markniu/PandaPi/doc/README.md

[Schematic_PandaPiV2.8.pdf](https://gitee.com/markyue/pandapi_wiki/raw/master/imges/doc/Schematic_PandaPiV2.8.pdf)
