markniu/PandaPi/doc/imags/0317112637.jpg

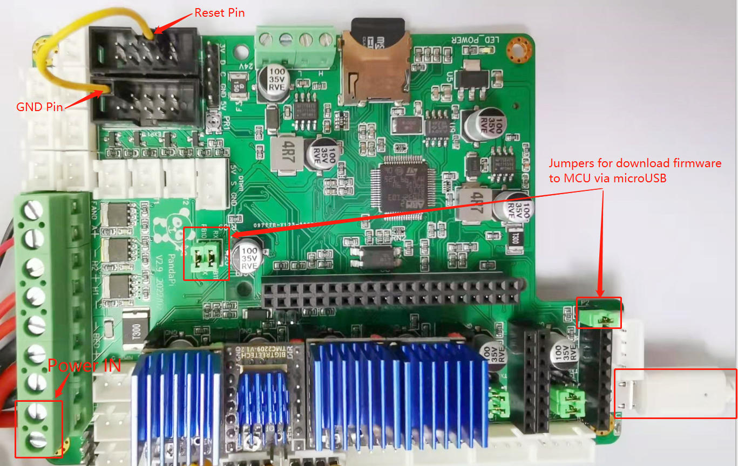
doc/imags/0317112637.jpg
