markniu/PandaPi/doc/imags/317113609.jpg

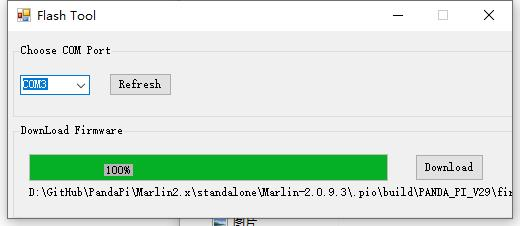
doc/imags/317113609.jpg
