markniu/PandaPi/(threads)

Thread 1 (2019-10-20):

Request for information (Thingiverse)

AJMartel, 2019-10-20:
I contacted you on Thingiverse.

Would you be able to give me the exact version of Marlin that you used?

This way I will be able to figure out exactly what changes and additions you made to make Marlin work on the RaspberryPi. Together we will be able to port your project over to Marlin v2.x.

By communicating through Github, we can track the progress of the project.
You will remain in control of this fork and I will become a contributor to your project, any changes/additions would be passed to you through the Pull requests giving you full control of any changes.

daimein2007, 2019-10-20:
https://github.com/markniu/PandaPi

On Sun, Oct 20, 2019 at 12:11 PM Alain Martel <notifications@github.com>
wrote:

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

markniu, 2019-10-21:
Hi @AJMartel  the exact version of Marlin is the latest released version 1.1.9 last year.

AJMartel, 2019-10-22:
Looks like you originally where using https://github.com/hackaday3D/marlin_stm32
which was based off of Marlin 1.1 - 2018 Aug 2 Patch level
Some of the fixes do not line up, I will find the starting point.

AJMartel, 2019-10-23:
stm32 is included in the Marlin v2 branch porting it over should be easier than remaining on the v1.1 branch, I am still trying to figure out all the relevant changes required.

markniu, 2019-10-24:
yes, Marlin2.0 has the HAL for different MCU

Thread 2 (2020-01-04):

M851 not available

LeonKnook, 2020-01-04:
I have not received the board but I'm preparing the PI. I have managed to burn the image, wifi and all that and started Octoprint with no problem at all. What I noticed is that the command M851 is not available and I like that command a lot to adjust the printing height after the probing with my conductive probe. I could not found anywhere the right settings in Marlin to activate M851. Any suggestion or alternative method to adjust the printing height with auto bed tilt height correction after probing?

markniu, 2020-01-05:
the M851 needs that one of the bed probe been enabled.you can just enable the "BLTOUCH" in the Configuration.h even you have not bltouch but conductive probe，for that z probe pin and z endstop pin is the same.

LeonKnook, 2020-01-05:
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
Good advice that solved the problem. Thank you Mark!

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

Thread 3 (2020-01-14):

Klipper

Klinenator, 2020-01-14:
Is it possible to run klipper on this board instead of marlin? I know klipper is overkill but i find changing the config on klipper and restarting the server is a lot easier than recompiling marlin when making changes

Thanks

markniu, 2020-01-15:
except the temperature and fans,all other pins are connected to RaspberryPi directly, not connected to onboard MCU, so that it cannot run Klipper.
with RaspberryPI you can run/edit/compile marlin on raspberrypi, sometimes I use phone browser to debug the printer.

Thread 4 (2020-01-16):

pandapi 6 drivers schematic

ememem13, 2020-01-16:
Available pandapi 6 drivers schematic,
with component values?

Moorviper, 2020-01-16:
it has no drivers ;-)

ememem13, 2020-01-17:
Schematic?

markniu, 2020-04-07:
Schematic: https://github.com/markniu/PandaPi/tree/master/doc

Thread 5 (2020-01-17):

Files

furkanbr, 2020-01-17:
Hi , this is a great project and i want to work on this , can you share platformio.ini file for us?

markniu, 2020-01-18:
it is not compiled on platformio, it is compiled and run on raspberry pi Linux.  just run make command in the Linux

furkanbr, 2020-01-20:
How is it compiling ? is it happening automaticaly when i copy source code to root directory ?

and can i use my Rpi 3 a+ or it should be minimum 3b?

markniu, 2020-01-20:
both Pi3b and Pi3b+  are OK , here is the edit and compile steps
 https://github.com/markniu/PandaPi/wiki/How-to-Edit-Marlin-code

furkanbr, 2020-01-25:
Can you tell me how did yo change serial port comminication in marlin firmware? im trying to do somethink at my arm stm32f4 but i didt figure that .

markniu, 2020-01-26:
You can  compare the it with original marlin code, e.g. marlinseral.cpp

Moorviper, 2021-04-04:
I think this can be closed.

Thread 6 (2020-01-18):

Error when clicking run

Klinenator, 2020-01-18:
Im getting this error after click verify then run

cp: cannot stat '/media/usb/pandapi//pi_marlin': No such file or directory

Klinenator, 2020-01-18:
I believe the issue is that when it goes to make the file pi_marlin there is an error which is causing the error above

markniu, 2020-01-18:
after click verify it will compile the source and make the pi_marlin. did you see some error log after you click the verify?

Klinenator, 2020-01-19:
stderr:temperature.h: In static member function ‘static void Temperature::updatePID()’:
temperature.h:581:17: warning: comparison of integer expressions of different signedness: ‘int’ and ‘size_t’ {aka ‘unsigned int’} [-Wsign-compare]
    for(int i=0;i<strlen(tmp_data);i++)
                ~^~~~~~~~~~~~~~~~~
stderr:temperature.h:597:17: warning: comparison of integer expressions of different signedness: ‘int’ and ‘size_t’ {aka ‘unsigned int’} [-Wsign-compare]
    for(int i=0;i<strlen(tmp_data);i++)
                ~^~~~~~~~~~~~~~~~~
stderr:temperature.h:613:17: warning: comparison of integer expressions of different signedness: ‘int’ and ‘size_t’ {aka ‘unsigned int’} [-Wsign-compare]
    for(int i=0;i<strlen(tmp_data);i++)
                ~^~~~~~~~~~~~~~~~~
stderr:temperature.h:577:9: warning: unused variable ‘e’ [-Wunused-variable]
    char e=0;
         ^
stderr:Marlin_main.cpp: In function ‘void setup()’:
Marlin_main.cpp:14693:35: error: too many arguments to function ‘void step_motor_init(void (*)())’
    step_motor_init(stepper.isr,4*8); //mark
                                   ^
stderr:In file included from Marlin_main.cpp:288:
/home/pi/src/CMSIS/driver_api.h:74:6: note: declared here
 void step_motor_init(void(*step_isr)(void));
      ^~~~~~~~~~~~~~~
Marlin_main.cpp:14695:34: error: too many arguments to function ‘void step_motor_init(void (*)())’
    step_motor_init(stepper.isr,12); //mark
                                  ^
In file included from Marlin_main.cpp:288:
/home/pi/src/CMSIS/driver_api.h:74:6: note: declared here
 void step_motor_init(void(*step_isr)(void));
      ^~~~~~~~~~~~~~~
Marlin_main.cpp:14697:33: error: too many arguments to function ‘void step_motor_init(void (*)())’
    step_motor_init(stepper.isr,8); //mark
                                 ^
In file included from Marlin_main.cpp:288:
/home/pi/src/CMSIS/driver_api.h:74:6: note: declared here
 void step_motor_init(void(*step_isr)(void));
      ^~~~~~~~~~~~~~~
stderr:Marlin_main.cpp: In function ‘int test(int, char**)’:
Marlin_main.cpp:15038:41: warning: ISO C++ forbids converting a string constant to ‘char*’ [-Wwrite-strings]
    GetCurrentPath(buf,"Config_panda.ini");
                                         ^
stderr:Marlin_main.cpp:15044:68: warning: ISO C++ forbids converting a string constant to ‘char*’ [-Wwrite-strings]
    iCatAge = GetIniKeyInt("CAT","age","/media/usb/Config_panda.ini");
                                                                    ^
Marlin_main.cpp:15044:68: warning: ISO C++ forbids converting a string constant to ‘char*’ [-Wwrite-strings]
Marlin_main.cpp:15044:68: warning: ISO C++ forbids converting a string constant to ‘char*’ [-Wwrite-strings]
Marlin_main.cpp:15045:58: warning: ISO C++ forbids converting a string constant to ‘char*’ [-Wwrite-strings]
    char *a = GetIniKeyString("CAT4","name",g_szConfigPath);
                                                          ^
Marlin_main.cpp:15045:58: warning: ISO C++ forbids converting a string constant to ‘char*’ [-Wwrite-strings]
stderr:Marlin_main.cpp:15042:9: warning: unused variable ‘szCatName’ [-Wunused-variable]
    char szCatName[32];
         ^~~~~~~~~
Marlin_main.cpp:15056:6: warning: unused variable ‘cn’ [-Wunused-variable]
  int cn=0;
      ^~
stderr:Marlin_main.cpp: At global scope:
Marlin_main.cpp:15001:16: warning: ‘i2cMode’ defined but not used [-Wunused-variable]
 static uint8_t i2cMode = 0;
                ^~~~~~~
stderr:Marlin_main.cpp:14974:1: warning: ‘int GPIOWrite(int, int)’ defined but not used [-Wunused-function]
 GPIOWrite(int pin, int value)
 ^~~~~~~~~
Marlin_main.cpp:14949:1: warning: ‘int GPIORead(int)’ defined but not used [-Wunused-function]
 GPIORead(int pin)
 ^~~~~~~~
stderr:Marlin_main.cpp:14924:1: warning: ‘int GPIODirection(int, int)’ defined but not used [-Wunused-function]
 GPIODirection(int pin, int dir)
 ^~~~~~~~~~~~~
Marlin_main.cpp:14905:1: warning: ‘int GPIOUnexport(int)’ defined but not used [-Wunused-function]
 GPIOUnexport(int pin)
 ^~~~~~~~~~~~
Marlin_main.cpp:14885:1: warning: ‘int GPIOExport(int)’ defined but not used [-Wunused-function]
 GPIOExport(int pin)
 ^~~~~~~~~~
stderr:make: *** [Makefile:24: Marlin_main.o] Error 1
make: Leaving directory '/media/usb/pandapi'
stdclose:2

Klinenator, 2020-01-19:
Thats what i get when i try to make in that directory manually

markniu, 2020-01-20:
it seems that some of the file not update, "Marlin_main.cpp:14695:34: error: too many arguments to function ‘void step_motor_init(void ()())’",   check or download again the pandapi folder, which pi do you used pi3+or pi4? and which img file did you download?

Klinenator, 2020-01-20:
Pi4 and the pi4 img

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

markniu, 2020-01-20:
I will check it later today

markniu, 2020-01-20:
sorry for the out of update source for pi4, and now you can update the new github pandapi foler.

Klinenator, 2020-01-22:
Ok the update worked

Now i get this error when changing to TMC2130

 error: #error "Y_CS_PIN is required for TMC2130. Define Y_CS_PIN in Configuration_adv.h."
   #error "Y_CS_PIN is required for TMC2130. Define Y_CS_PIN in Configuration_adv.h."

markniu, 2020-01-22:
you can run as a4988 or tmc2208 model with TMC2130 first. niujl123 Email:niujl123@sina.com Signature is customized by Netease Mail Master On 01/22/2020 09:33, Klinenator wrote: Ok the update worked Now i get this error when changing to TMC2130 error: #error "Y_CS_PIN is required for TMC2130. Define Y_CS_PIN in Configuration_adv.h." #error "Y_CS_PIN is required for TMC2130. Define Y_CS_PIN in Configuration_adv.h." — You are receiving this because you commented. Reply to this email directly, view it on GitHub, or unsubscribe.

Thread 7 (2020-02-19):

PID autotune does not work

LeonKnook, 2020-02-19:
Today I updated everything possible in de marlin files to make PID autotune work.
It does not heat up at all.
Over here a zip file with my marlin version so far, maybe I overlooked something?

[pandapi.zip](https://github.com/markniu/PandaPi/files/4223976/pandapi.zip)

markniu, 2020-02-20:
hello, V1.0 board needs to update new MCU firmware,
https://github.com/markniu/PandaPi/tree/master/firmware
https://github.com/markniu/PandaPi/wiki/How-to-flash-MCU-firmware

LeonKnook, 2020-02-29:
Purchased the ST-Link USB module and uploaded the new firmware. I confirm that the PID autotune works now. In my case the temperature is unfortunately 5 degrees to low.

markniu, 2020-02-29:
did you update the latest firmware and marlin code that I had updated the yesterday? how about the default Value of PID?or try to ''M303 C10 S210  '' instead of "M303 S210"

LeonKnook, 2020-02-29:
I refreshed the 3 marlin files you uploaded yesterday and the latest firmware I already had.
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
These are the results
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

LeonKnook, 2020-02-29:
And then I printed something
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
Still around 5 degrees to cold.

markniu, 2020-02-29:
it seems that the RPI  print out wrong PID ,I am doing test. set the PID default :
M301 P25 I2.4 D66.9
M500

LeonKnook, 2020-03-01:
The PID default give bad results.
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

markniu, 2020-03-01:
sorry for that bad temperature. so I do more test and fixed it today,but need more test,if you have time you can try to update this new firmware and marlin . following is my test results.
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   the PID value:  P25.00 I2.40 D66.90

LeonKnook, 2020-03-01:
temperature.h replaced and latest hex file geupload.
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

markniu, 2020-03-03:
the I0.002 is too low, try  I1, or increase P and D value.   when the autotune failed, try again.did it failed everytime?

markniu, 2020-03-14:
I find that the bed temperature on you board are not stable, because of the noise of the hardware or connect line,so I fixed it with the software,you can update the new firmware.
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

Thread 9 (2020-03-13):

printer halted. kill() called

kine3000, 2020-03-13:
I get this error "printer halted.kill() called" everytime I want to home the axis. Theres no more information about the error written on the terminal.
Also I cant move any axis anyway even before this error occuring.
I've got an pandapi v2.0 with an raspberry pi 4b with octoprint running. Connection is fine. Temperatures are fine. Marlin code editing works fine. I use the original Marlin firmware version out of the "pandapi" folder with small corrections. Drivers are all A4988's and also defined this way in marlin. I have mechanical endstops and defined them correctly also checked them using M119.
I just dont get any driving voltage to the motors. I checked the correct wiring of the 4 pin connections as well. Vdd and Vmot on the drivers is correct.
I dont have any lcd display but that shouldnt be the problem.

What else can I check?

markniu, 2020-03-14:
you can check the En pin on the A4988, that should be low,and the motors can be locked.
also check the GPIO40 connector between PRI and pandapi is connected well.
test it with only one A4988 plugged in first.
Be careful the driver is easily damaged.

kine3000, 2020-03-17:
I can disable/enable the motor now with the M17/M18 command. The En pin is working fine and in lock mode i have voltage on both spoils of the motor. But there is no moving with G1 command and there is still the problem of the error message coming up with homing. The driver voltage is set to 0.625V and i checked other ones as well so I guess that shouldnt be the Problem too.
It seems to me like a software problem but i cant think of any marlin configurations that would be responsible for this.
Maybe there are some other ideas how to come to a solution?
Thanks for support! Its great!

markniu, 2020-03-18:
yeah,if the motor is locked that means En is working,if can not move probably the step pin has no input signal. so the step pin needs to be checked, and can you move other motors with G1?

kine3000, 2020-03-30:
I'm having a more deeper problem in connection right now i think. After connecting successfully with octopi and sending M17/M18 to enable/disable the motors there is no change on the pi gpio17 (pin 11) at all, but the connection is still working like i get temperatures informations and can control the fan etc.
I also updated the pandapi image and the marlin 2.0 on the u disk without any problem.
Maybe somebody has any ideas cause i dont have anymore :D

Thread 10 (2020-03-24):

Can't Download pi3 file from mega

Saboiatota, 2020-03-24:
On march, 24 2020

After logged in on mega, the download procedure finished ok, but galena etcher can't handle the zip file. "Something went wrong while opening pandapi3_20200307.zip

Error: Can't find a matching file in this zip archive"

Any alternate repo?

markniu, 2020-03-25:
Hi Saboiatota,
thanks for correct this!
BTW, I just upload the new version of Marlin2.0.4.4 for pi3,Marlin2x_pandapi3_20020325.zip

Moorviper, 2020-07-31:
unzipping on mac doesn't work with the apple application.
Use https://www.keka.io/en/

Thread 11 (2020-04-05):

ramps 1.4 + panda pi

lelibreauquotidien, 2020-04-05:
Hello.
I would like to use a 1.4 ramps with panda pi, are there any additional components apart from those present on the ramps and the raspberry pi?
Thank you in advance.

keczejo, 2020-04-05:
PandaPi have stm32 mcu for controling temps

lelibreauquotidien, 2020-04-06:
Is it possible to use an arduino instead?

keczejo, 2020-04-06:
source code for stm is not public yet

lelibreauquotidien, 2020-04-06:
OK, is the communication between the stm and the raspi done with TX and RX?
Thank you.

keczejo, 2020-04-15:
STM32 and rpi are comunicating with i2c

Thread 12 (2020-04-14):

Compile STM32F103C8 firmware from source

wmzart, 2020-04-14:
Hello,

Where can I find the source of the firmware for the STFM32F103C8 controller?

I would like to try to build the source myself.

Thanks!

Marc

wmzart, 2020-04-14:
User @keczejo already mentioned that the "... source code for stm is not public yet ...". [(See here)](https://github.com/markniu/PandaPi/issues/11#issuecomment-609736296). So when are these files going to be released?

markniu, 2020-04-15:
After selling 1,000 of this board, the firmware will be open source, :)

wmzart, 2020-04-15:
Cool! That would be fantastic.

wmzart, 2021-04-02:
Either you have sold at least 1000 of these boards or you changed your mind. Nevertheless a big thanks for providing the source!

https://github.com/markniu/PandaPi/tree/master/firmware/pandapi_stm32f103

Closed 2021-04-02.

Thread 13 (2020-05-14):

[info] Started to draw vector graphics for documentation.

Moorviper, 2020-05-14:
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
Hi mark for you to know i am currently do some vector graphics of your board which you can use for documentation.
It is not finished yet ... but in the work.

markniu, 2020-05-15:
Great! Many others want this 3d file that I don't have.

Moorviper, 2020-05-15:
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
Unsure if i rotate all text in one direction.
I don't draw the resistors but i have to check for the led's :D

markniu, 2020-06-11:
that's great.Thank you so much!
about the fans, I just draw this [image](https://github.com/markniu/PandaPi/wiki/How-to-wire),hope that help!
![Uploading 图片.png…]()

I learn the Altium Designer tool, and had draw this[ board 3D file](https://drive.google.com/drive/folders/1Imnye9MxCWCUlUC2pw_A6A5WoUFMV1xj?usp=sharing) this week.

Closed 2020-06-11.

Thread 14 (2020-05-29):

Closed Loop Motor Support.

designerwebhosting, 2020-05-29:
Does the Pandapi Hat support Closed Loop Motors? Or is it just updating the Marlin config to use them? Thank you.

markniu, 2020-05-29:
Hi, just like other 3D printer control board, only support step motor driver TMC2209/2208/ A4988 ..., not support closed loop motor. it based on the marlin,so the configuration is the same.

Moorviper, 2020-05-29:
As far i know do you use closed loop driver just as A4988. You don't have to change anything in firmware.
1/16 micro stepping and you are good to go

Thread 15 (2020-06-12):

suggestion:  Differentiate 24v and non-24v fan sockets

ChrisWeiss, 2020-06-12:
I really like the support for multiple fan voltages. It might be helpful to use different style sockets for the 24v fan sockets than the non-24v fan sockets, when things are that close together, it can be easy to plug things in incorrectly. With fans, the user may not find out until the fan burns out after a few hours at the wrong voltage.

Maybe change socket style or color between the two types?

Moorviper, 2020-06-13:
Only the 2nd row is adjustable.

markniu, 2020-06-13:
That's a good suggestion, I will change the color of non -24v fan sockets.

markniu, 2020-08-09:
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

Closed 2020-08-09.

Thread 16 (2020-06-25):

TMC2130 SPI?

sl1pkn07, 2020-06-25:
Hi. is possible use TMC2130/TMC5160 in SPI mode?

greetigs

markniu, 2020-06-26:
not support SPI,only uart model for TMC2208/2209

Thread 18 (2020-07-20):

Question

dgrammatiko, 2020-07-20:
Does PandaPi supports (or will ever support) 2208 in UART mode?

markniu, 2020-07-20:
Yes, the PandaPi supports TMC2208 now, and make sure this pin is uart,else you need to wire it.
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

dgrammatiko, 2020-07-20:
Nice, thanks

Closed 2020-07-20.

Thread 21 (2020-08-10):

Stepper motor makes hissing noise

chibisuke, 2020-08-10:
I today received my first PandaPi and I was attemping to test it, but I'm having the following problem now:

The Steper motor that is connected to the extruder port is making a really louse hissing noise.
I Tried:
- swapping the driver (TMC2209)
- Swaping the stepper motor
- Swaping the extruder port on the pandaPI board (E0 to E1)

Since im after swapping pretty much everything out the problem can't be related to any hardare component (Except maybe the pandapi board itself, I don't know), I suspect a software issue.

Any hints on how to troubleshoot this further?

Moorviper, 2020-08-10:
its a wiring issue

chibisuke, 2020-08-11:
Thx for your reply. Unfortunately I'm pretty sure it got nothing to do with wireing, sind I switched around the cabels, steppers and drivers already.

The only thing that made a difference is changing the UART ID of the driver, so I would strongly guess that its a problem with the config that gets sent to the driver by marlin via uart.

markniu, 2020-08-11:
this is strange! you can set the drivers as standalone mode to see if it's uart problem,just put the MS1/MS2 jumpers on, and pull out the jumppers near the raspberry GPIO.

chibisuke, 2020-08-11:
In standalone mode the problem is gone, so it definitly got somthing to do with the UART config that is sent.

Any more ideas on how to procede to get the UART running properly?

markniu, 2020-08-11:
does this noise happens only in extruder port?

chibisuke, 2020-08-11:
In the default setup it only happens on the extruder port. If I setup any other port (x,y - didn't test z) as having UART ID 3 on the driver, the problem moves there.

markniu, 2020-08-11:
did you changed some configure? I will check it later today or tomorrow.

Moorviper, 2020-08-11:
Normally when you have the hissing sound you have to much current or a bad wiring.
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

chibisuke, 2020-08-11:
@markniu only for testing to troubleshoot it, but reverted it completely.

@Moorviper yea, but if it would be a wiring issue why would it only occure on a stepper connected to a driver that has UART ID 3 set and disapear if I switch the driver to standalone mode? that doesn't make sense at all.
To much current would propably heat up the stepper very quickly, but would still be an option, since as far as I understood the TMC2209 can control the current via uart.
Even though I already tried to check this in the config files, and didn't find anything, there still might be something I'm overlooking there.

chibisuke, 2020-08-13:
Still no idea where this is comming from.

Its not appearing in standalone mode, but as soon as I set the UART jumper in the board the problem is there, if one of the stepper is configure to use UART ID 2 (both jumpers set).
If I'm giving it another ID then 2 (like remove both jumpers, it works, but obviously the config is not what its surposed to be then.

Any ideas?

chibisuke, 2020-09-29:
In the meanwhile I switched to an SKR 1.4, with the same stepper drivers, same cabels, same steppers and the same settings. There is works without any problems. So either the PandaPI board, has a serios problem somewhere or the hacked marlin in making trouble.

anyway, since there is no support comming from the developers here, the purchase was just a huge waste of money to me, so anyone considder buying a pandapi board, I can only strongly recommend... don't do it.

Thread 22 (2020-08-13):

Creality CR-20: No LCD & Endstop does not stop movement

sergiofenoll, 2020-08-13:
Hello!

I am using a PandaPi v2.5 with my Creality CR-20, followed the flashing and wiring instructions, but I do not get any output on the LCD (I think maybe I need to install U8glib, but I'm not sure how to do that since it's not explained in the Configuration.h file).

Also, while moving the extruder works, when the endstop is reached, it doesn't stop automatically.

Any ideas about what I'm doing wrong?

Moorviper, 2020-08-13:
Try:
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

markniu, 2020-08-14:
the U8glib source code has been contained in and will be auto compiled.

markniu, 2020-08-14:
Did it reach the endstop and not stop while homing ?

Thread 23 (2020-08-31):

I been try to enable a dual z but i get this error at the time of compile the file.

EMDM25, 2020-08-31:
^
src/module/temperature.cpp:2682:39: warning: ISO C++ forbids converting a string constant to ‘char*’ [-Wwrite-strings]
src/module/temperature.cpp:2685:38: warning: ISO C++ forbids converting a string constant to ‘char*’ [-Wwrite-strings]
   parse_string(cmd_buf,"B:","",out,&k);
                                      ^
src/module/temperature.cpp:2685:38: warning: ISO C++ forbids converting a string constant to ‘char*’ [-Wwrite-strings]
stderr:src/module/temperature.cpp:2688:39: warning: ISO C++ forbids converting a string constant to ‘char*’ [-Wwrite-strings]
   parse_string(cmd_buf,"T1:","",out,&k);
                                       ^
src/module/temperature.cpp:2688:39: warning: ISO C++ forbids converting a string constant to ‘char*’ [-Wwrite-strings]
src/module/temperature.cpp:2707:39: warning: ISO C++ forbids converting a string constant to ‘char*’ [-Wwrite-strings]
    parse_string(cmd_buf,"h","T",out,&k);
                                       ^
stderr:src/module/temperature.cpp:2707:39: warning: ISO C++ forbids converting a string constant to ‘char*’ [-Wwrite-strings]
#arm-linux-gnueabihf-g++ -I./  -I./src/lcd/dogm  -I/home/pi/src/CMSIS -I/home/pi/src/utility -ITMC2208Stepper -I/home/pi/src/CMSIS-W -I./lib/TMCStepper-master/src/source/-I./lib/TMCStepper-master/src/ -I./lib/NeoPixel_LED/ -Wall -g0 -lm -O0 -c     -std=c++11 -D PANDAPI -Wall -cpp src/module/stepper.cpp Configuration.h Configuration_831_1639.h Configuration_831_212.h Configuration_adv.h Configuration_adv_831_1639.h Configuration_adv_831_212.h Version.h pins_PANDA_PI.h pins_PANDA_PI_831_1639.h pins_PANDA_PI_831_212.h -o src/module/stepper.o
#arm-linux-gnueabihf-g++ -I./  -I./src/lcd/dogm  -I/home/pi/src/CMSIS -I/home/pi/src/utility -ITMC2208Stepper -I/home/pi/src/CMSIS-W -I./lib/TMCStepper-master/src/source/-I./lib/TMCStepper-master/src/ -I./lib/NeoPixel_LED/ -Wall -g0 -lm -O0 -c     -std=c++11 -D PANDAPI -Wall -cpp src/module/temperature.cpp Configuration.h Configuration_831_1639.h Configuration_831_212.h Configuration_adv.h Configuration_adv_831_1639.h Configuration_adv_831_212.h Version.h pins_PANDA_PI.h pins_PANDA_PI_831_1639.h pins_PANDA_PI_831_212.h -o src/module/temperature.o
stderr:In file included from src/module/tool_change.cpp:30:
src/module/temperature.h: In static member function ‘static void Temperature::setTargetHotend(int16_t, uint8_t)’:
src/module/temperature.h:602:17: warning: comparison of integer expressions of different signedness: ‘int’ and ‘size_t’ {aka ‘unsigned int’} [-Wsign-compare]
    for(int i=0;i<strlen(tmp_data);i++)
                ~^~~~~~~~~~~~~~~~~
stderr:src/module/temperature.h: In static member function ‘static void Temperature::setTargetBed(int16_t)’:
src/module/temperature.h:676:17: warning: comparison of integer expressions of different signedness: ‘int’ and ‘size_t’ {aka ‘unsigned int’} [-Wsign-compare]
    for(int i=0;i<strlen(tmp_data);i++)
                ~^~~~~~~~~~~~~~~~~
stderr:In file included from src/module/tool_change.cpp:30:
src/module/temperature.h: In static member function ‘static void Temperature::updatePID()’:
src/module/temperature.h:794:17: warning: comparison of integer expressions of different signedness: ‘int’ and ‘size_t’ {aka ‘unsigned int’} [-Wsign-compare]
    for(int i=0;i<strlen(tmp_data);i++)
                ~^~~~~~~~~~~~~~~~~
stderr:src/module/temperature.h:810:17: warning: comparison of integer expressions of different signedness: ‘int’ and ‘size_t’ {aka ‘unsigned int’} [-Wsign-compare]
    for(int i=0;i<strlen(tmp_data);i++)
                ~^~~~~~~~~~~~~~~~~
stderr:src/module/temperature.h:826:17: warning: comparison of integer expressions of different signedness: ‘int’ and ‘size_t’ {aka ‘unsigned int’} [-Wsign-compare]
    for(int i=0;i<strlen(tmp_data);i++)
                ~^~~~~~~~~~~~~~~~~
stderr:src/module/temperature.h:790:9: warning: unused variable ‘e’ [-Wunused-variable]
    char e=0;
         ^
#arm-linux-gnueabihf-g++ -I./  -I./src/lcd/dogm  -I/home/pi/src/CMSIS -I/home/pi/src/utility -ITMC2208Stepper -I/home/pi/src/CMSIS-W -I./lib/TMCStepper-master/src/source/-I./lib/TMCStepper-master/src/ -I./lib/NeoPixel_LED/ -Wall -g0 -lm -O0 -c     -std=c++11 -D PANDAPI -Wall -cpp src/module/tool_change.cpp Configuration.h Configuration_831_1639.h Configuration_831_212.h Configuration_adv.h Configuration_adv_831_1639.h Configuration_adv_831_212.h Version.h pins_PANDA_PI.h pins_PANDA_PI_831_1639.h pins_PANDA_PI_831_212.h -o src/module/tool_change.o
make: Leaving directory '/home/pi/PandaPI/Marlin2.x/pandapi'
compile failed !stdclose:2compile failed !

markniu, 2020-09-01:
Hi, this log is short and have not contain the error infor. but at the same time I received your another emails that have have the error infor.
    "void beginSerial(uint32_t) = delete; // Your platform does not currently support Software Serialstderr:make: *** [Makefile:36: src/module/stepper/trinamic.o] Error 1"
    the pandapi use only one hardware uart TX pin for all the drivers.
so if you use TMC2209 for Z2, uncomment "#define Z2_HARDWARE_SERIAL customizedSerial1" in the pins_PANDA_PI.h instead of use "Z2_SERIAL_TX_PIN "if you still have problems, you can send me your changed configure files,I will check it.

EMDM25, 2020-09-01:
That was the problem Sorry I didn't know that I have to enable it there.

EMDM25, 2020-09-01:
Thanks

EMDM25, 2020-09-01:
But know when I try to enable ZStepperAlign I got this error.

arm-linux-gnueabihf-g++ -O0 -c     -std=c++11 -D PANDAPI  -I./lib  -I./lib/NeoPixel_LED  -I./lib/TMCStepper-master  -I./lib/TMCStepper-master/examples  -I./lib/TMCStepper-master/examples/Calibrate_spreadCycle  -I./lib/TMCStepper-master/examples/Live_tune  -I./lib/TMCStepper-master/examples/Simple  -I./lib/TMCStepper-master/examples/Software_SPI  -I./lib/TMCStepper-master/examples/StallGuard  -I./lib/TMCStepper-master/examples/StallGuard_TMC2209  -I./lib/TMCStepper-master/examples/StallGuard_TMC2660  -I./lib/TMCStepper-master/examples/TMC_AccelStepper  -I./lib/TMCStepper-master/extras  -I./lib/TMCStepper-master/src  -I./lib/TMCStepper-master/src/source  -I./src  -I./src/core  -I./src/feature  -I./src/feature/bedlevel  -I./src/feature/bedlevel/abl  -I./src/feature/bedlevel/mbl  -I./src/feature/bedlevel/ubl  -I./src/feature/dac  -I./src/feature/digipot  -I./src/feature/leds  -I./src/feature/mmu2  -I./src/feature/touch  -I./src/gcode  -I./src/gcode/bedlevel  -I./src/gcode/bedlevel/abl  -I./src/gcode/bedlevel/mbl  -I./src/gcode/bedlevel/ubl  -I./src/gcode/calibrate  -I./src/gcode/config  -I./src/gcode/control  -I./src/gcode/eeprom  -I./src/gcode/feature  -I./src/gcode/feature/advance  -I./src/gcode/feature/baricuda  -I./src/gcode/feature/camera  -I./src/gcode/feature/cancel  -I./src/gcode/feature/caselight  -I./src/gcode/feature/clean  -I./src/gcode/feature/controllerfan  -I./src/gcode/feature/digipot  -I./src/gcode/feature/filwidth  -I./src/gcode/feature/fwretract  -I./src/gcode/feature/i2c  -I./src/gcode/feature/L6470  -I./src/gcode/feature/leds  -I./src/gcode/feature/macro  -I./src/gcode/feature/mixing  -I./src/gcode/feature/pause  -I./src/gcode/feature/powerloss  -I./src/gcode/feature/power_monitor  -I./src/gcode/feature/prusa_MMU2  -I./src/gcode/feature/runout  -I./src/gcode/feature/trinamic  -I./src/gcode/geometry  -I./src/gcode/host  -I./src/gcode/lcd  -I./src/gcode/motion  -I./src/gcode/probe  -I./src/gcode/scara  -I./src/gcode/sd  -I./src/gcode/stats  -I./src/gcode/temp  -I./src/gcode/units  -I./src/HAL  -I./src/HAL/HAL_PANDAPI  -I./src/HAL/HAL_PANDAPI/fastio  -I./src/HAL/HAL_PANDAPI/inc  -I./src/HAL/LINUX  -I./src/HAL/LINUX/hardware  -I./src/HAL/LINUX/inc  -I./src/HAL/LINUX/include  -I./src/HAL/LPC1768  -I./src/HAL/LPC1768/inc  -I./src/HAL/LPC1768/include  -I./src/HAL/LPC1768/u8g  -I./src/HAL/LPC1768/win_usb_driver  -I./src/HAL/SAMD51  -I./src/HAL/SAMD51/inc  -I./src/HAL/shared  -I./src/HAL/shared/backtrace  -I./src/HAL/STM32  -I./src/HAL/STM32/inc  -I./src/HAL/STM32F1  -I./src/HAL/STM32F1/dogm  -I./src/HAL/STM32F1/inc  -I./src/HAL/STM32F1/maple_win_usb_driver  -I./src/HAL/STM32_F4_F7  -I./src/HAL/STM32_F4_F7/inc  -I./src/HAL/STM32_F4_F7/STM32F4  -I./src/HAL/STM32_F4_F7/STM32F7  -I./src/HAL/TEENSY31_32  -I./src/HAL/TEENSY31_32/inc  -I./src/HAL/TEENSY35_36  -I./src/HAL/TEENSY35_36/inc  -I./src/inc  -I./src/lcd  -I./src/lcd/dogm  -I./src/lcd/dogm/fontdata  -I./src/lcd/dwin  -I./src/lcd/extui  -I./src/lcd/extui/lib  -I./src/lcd/extui/lib/anycubic  -I./src/lcd/extui/lib/dgus  -I./src/lcd/extui/lib/dgus/fysetc  -I./src/lcd/extui/lib/dgus/hiprecy  -I./src/lcd/extui/lib/dgus/origin  -I./src/lcd/extui/lib/dgus/pandapi  -I./src/lcd/extui/lib/ftdi_eve_touch_ui  -I./src/lcd/extui/lib/ftdi_eve_touch_ui/archim2-flash  -I./src/lcd/extui/lib/ftdi_eve_touch_ui/ftdi_eve_lib  -I./src/lcd/extui/lib/ftdi_eve_touch_ui/ftdi_eve_lib/basic  -I./src/lcd/extui/lib/ftdi_eve_touch_ui/ftdi_eve_lib/extended  -I./src/lcd/extui/lib/ftdi_eve_touch_ui/ftdi_eve_lib/extended/unicode  -I./src/lcd/extui/lib/ftdi_eve_touch_ui/ftdi_eve_lib/extended/unicode/font_bitmaps  -I./src/lcd/extui/lib/ftdi_eve_touch_ui/ftdi_eve_lib/extras  -I./src/lcd/extui/lib/ftdi_eve_touch_ui/language  -I./src/lcd/extui/lib/ftdi_eve_touch_ui/screens  -I./src/lcd/extui/lib/ftdi_eve_touch_ui/theme  -I./src/lcd/extui/lib/mks_ui  -I./src/lcd/HD44780  -I./src/lcd/language  -I./src/lcd/menu  -I./src/lcd/menu/game  -I./src/lcd/utility  -I./src/libs  -I./src/libs/heatshrink  -I./src/libs/L64XX  -I./src/module  -I./src/module/stepper  -I./src/module/thermistor  -I./src/pins  -I./src/pins/esp32  -I./src/pins/linux  -I./src/pins/lpc1768  -I./src/pins/lpc1769  -I./src/pins/mega  -I./src/pins/rambo  -I./src/pins/ramps  -I./src/pins/sam  -I./src/pins/samd  -I./src/pins/sanguino  -I./src/pins/stm32f0  -I./src/pins/stm32f1  -I./src/pins/stm32f4  -I./src/pins/stm32f7  -I./src/pins/teensy2  -I./src/pins/teensy3  -I./src/sd  -I./src/sd/usb_flashdrive  -I./src/sd/usb_flashdrive/lib-uhs2  -I./src/sd/usb_flashdrive/lib-uhs3  -I./src/sd/usb_flashdrive/lib-uhs3/dyn_SWI  -I./src/sd/usb_flashdrive/lib-uhs3/UHS_host  -I./src/sd/usb_flashdrive/lib-uhs3/UHS_host/UHS_BULK_STORAGE  -I./src/sd/usb_flashdrive/lib-uhs3/UHS_host/USB_HOST_SHIELD  -I.  -c -o src/lcd/utility/u8g_state.o src/lcd/utility/u8g_state.c
arm-linux-gnueabihf-g++ -O0 -c     -std=c++11 -D PANDAPI  -I./lib  -I./lib/NeoPixel_LED  -I./lib/TMCStepper-master  -I./lib/TMCStepper-master/examples  -I./lib/TMCStepper-master/examples/Calibrate_spreadCycle  -I./lib/TMCStepper-master/examples/Live_tune  -I./lib/TMCStepper-master/examples/Simple  -I./lib/TMCStepper-master/examples/Software_SPI  -I./lib/TMCStepper-master/examples/StallGuard  -I./lib/TMCStepper-master/examples/StallGuard_TMC2209  -I./lib/TMCStepper-master/examples/StallGuard_TMC2660  -I./lib/TMCStepper-master/examples/TMC_AccelStepper  -I./lib/TMCStepper-master/extras  -I./lib/TMCStepper-master/src  -I./lib/TMCStepper-master/src/source  -I./src  -I./src/core  -I./src/feature  -I./src/feature/bedlevel  -I./src/feature/bedlevel/abl  -I./src/feature/bedlevel/mbl  -I./src/feature/bedlevel/ubl  -I./src/feature/dac  -I./src/feature/digipot  -I./src/feature/leds  -I./src/feature/mmu2  -I./src/feature/touch  -I./src/gcode  -I./src/gcode/bedlevel  -I./src/gcode/bedlevel/abl  -I./src/gcode/bedlevel/mbl  -I./src/gcode/bedlevel/ubl  -I./src/gcode/calibrate  -I./src/gcode/config  -I./src/gcode/control  -I./src/gcode/eeprom  -I./src/gcode/feature  -I./src/gcode/feature/advance  -I./src/gcode/feature/baricuda  -I./src/gcode/feature/camera  -I./src/gcode/feature/cancel  -I./src/gcode/feature/caselight  -I./src/gcode/feature/clean  -I./src/gcode/feature/controllerfan  -I./src/gcode/feature/digipot  -I./src/gcode/feature/filwidth  -I./src/gcode/feature/fwretract  -I./src/gcode/feature/i2c  -I./src/gcode/feature/L6470  -I./src/gcode/feature/leds  -I./src/gcode/feature/macro  -I./src/gcode/feature/mixing  -I./src/gcode/feature/pause  -I./src/gcode/feature/powerloss  -I./src/gcode/feature/power_monitor  -I./src/gcode/feature/prusa_MMU2  -I./src/gcode/feature/runout  -I./src/gcode/feature/trinamic  -I./src/gcode/geometry  -I./src/gcode/host  -I./src/gcode/lcd  -I./src/gcode/motion  -I./src/gcode/probe  -I./src/gcode/scara  -I./src/gcode/sd  -I./src/gcode/stats  -I./src/gcode/temp  -I./src/gcode/units  -I./src/HAL  -I./src/HAL/HAL_PANDAPI  -I./src/HAL/HAL_PANDAPI/fastio  -I./src/HAL/HAL_PANDAPI/inc  -I./src/HAL/LINUX  -I./src/HAL/LINUX/hardware  -I./src/HAL/LINUX/inc  -I./src/HAL/LINUX/include  -I./src/HAL/LPC1768  -I./src/HAL/LPC1768/inc  -I./src/HAL/LPC1768/include  -I./src/HAL/LPC1768/u8g  -I./src/HAL/LPC1768/win_usb_driver  -I./src/HAL/SAMD51  -I./src/HAL/SAMD51/inc  -I./src/HAL/shared  -I./src/HAL/shared/backtrace  -I./src/HAL/STM32  -I./src/HAL/STM32/inc  -I./src/HAL/STM32F1  -I./src/HAL/STM32F1/dogm  -I./src/HAL/STM32F1/inc  -I./src/HAL/STM32F1/maple_win_usb_driver  -I./src/HAL/STM32_F4_F7  -I./src/HAL/STM32_F4_F7/inc  -I./src/HAL/STM32_F4_F7/STM32F4  -I./src/HAL/STM32_F4_F7/STM32F7  -I./src/HAL/TEENSY31_32  -I./src/HAL/TEENSY31_32/inc  -I./src/HAL/TEENSY35_36  -I./src/HAL/TEENSY35_36/inc  -I./src/inc  -I./src/lcd  -I./src/lcd/dogm  -I./src/lcd/dogm/fontdata  -I./src/lcd/dwin  -I./src/lcd/extui  -I./src/lcd/extui/lib  -I./src/lcd/extui/lib/anycubic  -I./src/lcd/extui/lib/dgus  -I./src/lcd/extui/lib/dgus/fysetc  -I./src/lcd/extui/lib/dgus/hiprecy  -I./src/lcd/extui/lib/dgus/origin  -I./src/lcd/extui/lib/dgus/pandapi  -I./src/lcd/extui/lib/ftdi_eve_touch_ui  -I./src/lcd/extui/lib/ftdi_eve_touch_ui/archim2-flash  -I./src/lcd/extui/lib/ftdi_eve_touch_ui/ftdi_eve_lib  -I./src/lcd/extui/lib/ftdi_eve_touch_ui/ftdi_eve_lib/basic  -I./src/lcd/extui/lib/ftdi_eve_touch_ui/ftdi_eve_lib/extended  -I./src/lcd/extui/lib/ftdi_eve_touch_ui/ftdi_eve_lib/extended/unicode  -I./src/lcd/extui/lib/ftdi_eve_touch_ui/ftdi_eve_lib/extended/unicode/font_bitmaps  -I./src/lcd/extui/lib/ftdi_eve_touch_ui/ftdi_eve_lib/extras  -I./src/lcd/extui/lib/ftdi_eve_touch_ui/language  -I./src/lcd/extui/lib/ftdi_eve_touch_ui/screens  -I./src/lcd/extui/lib/ftdi_eve_touch_ui/theme  -I./src/lcd/extui/lib/mks_ui  -I./src/lcd/HD44780  -I./src/lcd/language  -I./src/lcd/menu  -I./src/lcd/menu/game  -I./src/lcd/utility  -I./src/libs  -I./src/libs/heatshrink  -I./src/libs/L64XX  -I./src/module  -I./src/module/stepper  -I./src/module/thermistor  -I./src/pins  -I./src/pins/esp32  -I./src/pins/linux  -I./src/pins/lpc1768  -I./src/pins/lpc1769  -I./src/pins/mega  -I./src/pins/rambo  -I./src/pins/ramps  -I./src/pins/sam  -I./src/pins/samd  -I./src/pins/sanguino  -I./src/pins/stm32f0  -I./src/pins/stm32f1  -I./src/pins/stm32f4  -I./src/pins/stm32f7  -I./src/pins/teensy2  -I./src/pins/teensy3  -I./src/sd  -I./src/sd/usb_flashdrive  -I./src/sd/usb_flashdrive/lib-uhs2  -I./src/sd/usb_flashdrive/lib-uhs3  -I./src/sd/usb_flashdrive/lib-uhs3/dyn_SWI  -I./src/sd/usb_flashdrive/lib-uhs3/UHS_host  -I./src/sd/usb_flashdrive/lib-uhs3/UHS_host/UHS_BULK_STORAGE  -I./src/sd/usb_flashdrive/lib-uhs3/UHS_host/USB_HOST_SHIELD  -I.  -c -o src/lcd/utility/u8g_u16toa.o src/lcd/utility/u8g_u16toa.c
arm-linux-gnueabihf-g++ -O0 -c     -std=c++11 -D PANDAPI  -I./lib  -I./lib/NeoPixel_LED  -I./lib/TMCStepper-master  -I./lib/TMCStepper-master/examples  -I./lib/TMCStepper-master/examples/Calibrate_spreadCycle  -I./lib/TMCStepper-master/examples/Live_tune  -I./lib/TMCStepper-master/examples/Simple  -I./lib/TMCStepper-master/examples/Software_SPI  -I./lib/TMCStepper-master/examples/StallGuard  -I./lib/TMCStepper-master/examples/StallGuard_TMC2209  -I./lib/TMCStepper-master/examples/StallGuard_TMC2660  -I./lib/TMCStepper-master/examples/TMC_AccelStepper  -I./lib/TMCStepper-master/extras  -I./lib/TMCStepper-master/src  -I./lib/TMCStepper-master/src/source  -I./src  -I./src/core  -I./src/feature  -I./src/feature/bedlevel  -I./src/feature/bedlevel/abl  -I./src/feature/bedlevel/mbl  -I./src/feature/bedlevel/ubl  -I./src/feature/dac  -I./src/feature/digipot  -I./src/feature/leds  -I./src/feature/mmu2  -I./src/feature/touch  -I./src/gcode  -I./src/gcode/bedlevel  -I./src/gcode/bedlevel/abl  -I./src/gcode/bedlevel/mbl  -I./src/gcode/bedlevel/ubl  -I./src/gcode/calibrate  -I./src/gcode/config  -I./src/gcode/control  -I./src/gcode/eeprom  -I./src/gcode/feature  -I./src/gcode/feature/advance  -I./src/gcode/feature/baricuda  -I./src/gcode/feature/camera  -I./src/gcode/feature/cancel  -I./src/gcode/feature/caselight  -I./src/gcode/feature/clean  -I./src/gcode/feature/controllerfan  -I./src/gcode/feature/digipot  -I./src/gcode/feature/filwidth  -I./src/gcode/feature/fwretract  -I./src/gcode/feature/i2c  -I./src/gcode/feature/L6470  -I./src/gcode/feature/leds  -I./src/gcode/feature/macro  -I./src/gcode/feature/mixing  -I./src/gcode/feature/pause  -I./src/gcode/feature/powerloss  -I./src/gcode/feature/power_monitor  -I./src/gcode/feature/prusa_MMU2  -I./src/gcode/feature/runout  -I./src/gcode/feature/trinamic  -I./src/gcode/geometry  -I./src/gcode/host  -I./src/gcode/lcd  -I./src/gcode/motion  -I./src/gcode/probe  -I./src/gcode/scara  -I./src/gcode/sd  -I./src/gcode/stats  -I./src/gcode/temp  -I./src/gcode/units  -I./src/HAL  -I./src/HAL/HAL_PANDAPI  -I./src/HAL/HAL_PANDAPI/fastio  -I./src/HAL/HAL_PANDAPI/inc  -I./src/HAL/LINUX  -I./src/HAL/LINUX/hardware  -I./src/HAL/LINUX/inc  -I./src/HAL/LINUX/include  -I./src/HAL/LPC1768  -I./src/HAL/LPC1768/inc  -I./src/HAL/LPC1768/include  -I./src/HAL/LPC1768/u8g  -I./src/HAL/LPC1768/win_usb_driver  -I./src/HAL/SAMD51  -I./src/HAL/SAMD51/inc  -I./src/HAL/shared  -I./src/HAL/shared/backtrace  -I./src/HAL/STM32  -I./src/HAL/STM32/inc  -I./src/HAL/STM32F1  -I./src/HAL/STM32F1/dogm  -I./src/HAL/STM32F1/inc  -I./src/HAL/STM32F1/maple_win_usb_driver  -I./src/HAL/STM32_F4_F7  -I./src/HAL/STM32_F4_F7/inc  -I./src/HAL/STM32_F4_F7/STM32F4  -I./src/HAL/STM32_F4_F7/STM32F7  -I./src/HAL/TEENSY31_32  -I./src/HAL/TEENSY31_32/inc  -I./src/HAL/TEENSY35_36  -I./src/HAL/TEENSY35_36/inc  -I./src/inc  -I./src/lcd  -I./src/lcd/dogm  -I./src/lcd/dogm/fontdata  -I./src/lcd/dwin  -I./src/lcd/extui  -I./src/lcd/extui/lib  -I./src/lcd/extui/lib/anycubic  -I./src/lcd/extui/lib/dgus  -I./src/lcd/extui/lib/dgus/fysetc  -I./src/lcd/extui/lib/dgus/hiprecy  -I./src/lcd/extui/lib/dgus/origin  -I./src/lcd/extui/lib/dgus/pandapi  -I./src/lcd/extui/lib/ftdi_eve_touch_ui  -I./src/lcd/extui/lib/ftdi_eve_touch_ui/archim2-flash  -I./src/lcd/extui/lib/ftdi_eve_touch_ui/ftdi_eve_lib  -I./src/lcd/extui/lib/ftdi_eve_touch_ui/ftdi_eve_lib/basic  -I./src/lcd/extui/lib/ftdi_eve_touch_ui/ftdi_eve_lib/extended  -I./src/lcd/extui/lib/ftdi_eve_touch_ui/ftdi_eve_lib/extended/unicode  -I./src/lcd/extui/lib/ftdi_eve_touch_ui/ftdi_eve_lib/extended/unicode/font_bitmaps  -I./src/lcd/extui/lib/ftdi_eve_touch_ui/ftdi_eve_lib/extras  -I./src/lcd/extui/lib/ftdi_eve_touch_ui/language  -I./src/lcd/extui/lib/ftdi_eve_touch_ui/screens  -I./src/lcd/extui/lib/ftdi_eve_touch_ui/theme  -I./src/lcd/extui/lib/mks_ui  -I./src/lcd/HD44780  -I./src/lcd/language  -I./src/lcd/menu  -I./src/lcd/menu/game  -I./src/lcd/utility  -I./src/libs  -I./src/libs/heatshrink  -I./src/libs/L64XX  -I./src/module  -I./src/module/stepper  -I./src/module/thermistor  -I./src/pins  -I./src/pins/esp32  -I./src/pins/linux  -I./src/pins/lpc1768  -I./src/pins/lpc1769  -I./src/pins/mega  -I./src/pins/rambo  -I./src/pins/ramps  -I./src/pins/sam  -I./src/pins/samd  -I./src/pins/sanguino  -I./src/pins/stm32f0  -I./src/pins/stm32f1  -I./src/pins/stm32f4  -I./src/pins/stm32f7  -I./src/pins/teensy2  -I./src/pins/teensy3  -I./src/sd  -I./src/sd/usb_flashdrive  -I./src/sd/usb_flashdrive/lib-uhs2  -I./src/sd/usb_flashdrive/lib-uhs3  -I./src/sd/usb_flashdrive/lib-uhs3/dyn_SWI  -I./src/sd/usb_flashdrive/lib-uhs3/UHS_host  -I./src/sd/usb_flashdrive/lib-uhs3/UHS_host/UHS_BULK_STORAGE  -I./src/sd/usb_flashdrive/lib-uhs3/UHS_host/USB_HOST_SHIELD  -I.  -c -o src/lcd/utility/u8g_u8toa.o src/lcd/utility/u8g_u8toa.c
arm-linux-gnueabihf-g++ -O0 -c     -std=c++11 -D PANDAPI  -I./lib  -I./lib/NeoPixel_LED  -I./lib/TMCStepper-master  -I./lib/TMCStepper-master/examples  -I./lib/TMCStepper-master/examples/Calibrate_spreadCycle  -I./lib/TMCStepper-master/examples/Live_tune  -I./lib/TMCStepper-master/examples/Simple  -I./lib/TMCStepper-master/examples/Software_SPI  -I./lib/TMCStepper-master/examples/StallGuard  -I./lib/TMCStepper-master/examples/StallGuard_TMC2209  -I./lib/TMCStepper-master/examples/StallGuard_TMC2660  -I./lib/TMCStepper-master/examples/TMC_AccelStepper  -I./lib/TMCStepper-master/extras  -I./lib/TMCStepper-master/src  -I./lib/TMCStepper-master/src/source  -I./src  -I./src/core  -I./src/feature  -I./src/feature/bedlevel  -I./src/feature/bedlevel/abl  -I./src/feature/bedlevel/mbl  -I./src/feature/bedlevel/ubl  -I./src/feature/dac  -I./src/feature/digipot  -I./src/feature/leds  -I./src/feature/mmu2  -I./src/feature/touch  -I./src/gcode  -I./src/gcode/bedlevel  -I./src/gcode/bedlevel/abl  -I./src/gcode/bedlevel/mbl  -I./src/gcode/bedlevel/ubl  -I./src/gcode/calibrate  -I./src/gcode/config  -I./src/gcode/control  -I./src/gcode/eeprom  -I./src/gcode/feature  -I./src/gcode/feature/advance  -I./src/gcode/feature/baricuda  -I./src/gcode/feature/camera  -I./src/gcode/feature/cancel  -I./src/gcode/feature/caselight  -I./src/gcode/feature/clean  -I./src/gcode/feature/controllerfan  -I./src/gcode/feature/digipot  -I./src/gcode/feature/filwidth  -I./src/gcode/feature/fwretract  -I./src/gcode/feature/i2c  -I./src/gcode/feature/L6470  -I./src/gcode/feature/leds  -I./src/gcode/feature/macro  -I./src/gcode/feature/mixing  -I./src/gcode/feature/pause  -I./src/gcode/feature/powerloss  -I./src/gcode/feature/power_monitor  -I./src/gcode/feature/prusa_MMU2  -I./src/gcode/feature/runout  -I./src/gcode/feature/trinamic  -I./src/gcode/geometry  -I./src/gcode/host  -I./src/gcode/lcd  -I./src/gcode/motion  -I./src/gcode/probe  -I./src/gcode/scara  -I./src/gcode/sd  -I./src/gcode/stats  -I./src/gcode/temp  -I./src/gcode/units  -I./src/HAL  -I./src/HAL/HAL_PANDAPI  -I./src/HAL/HAL_PANDAPI/fastio  -I./src/HAL/HAL_PANDAPI/inc  -I./src/HAL/LINUX  -I./src/HAL/LINUX/hardware  -I./src/HAL/LINUX/inc  -I./src/HAL/LINUX/include  -I./src/HAL/LPC1768  -I./src/HAL/LPC1768/inc  -I./src/HAL/LPC1768/include  -I./src/HAL/LPC1768/u8g  -I./src/HAL/LPC1768/win_usb_driver  -I./src/HAL/SAMD51  -I./src/HAL/SAMD51/inc  -I./src/HAL/shared  -I./src/HAL/shared/backtrace  -I./src/HAL/STM32  -I./src/HAL/STM32/inc  -I./src/HAL/STM32F1  -I./src/HAL/STM32F1/dogm  -I./src/HAL/STM32F1/inc  -I./src/HAL/STM32F1/maple_win_usb_driver  -I./src/HAL/STM32_F4_F7  -I./src/HAL/STM32_F4_F7/inc  -I./src/HAL/STM32_F4_F7/STM32F4  -I./src/HAL/STM32_F4_F7/STM32F7  -I./src/HAL/TEENSY31_32  -I./src/HAL/TEENSY31_32/inc  -I./src/HAL/TEENSY35_36  -I./src/HAL/TEENSY35_36/inc  -I./src/inc  -I./src/lcd  -I./src/lcd/dogm  -I./src/lcd/dogm/fontdata  -I./src/lcd/dwin  -I./src/lcd/extui  -I./src/lcd/extui/lib  -I./src/lcd/extui/lib/anycubic  -I./src/lcd/extui/lib/dgus  -I./src/lcd/extui/lib/dgus/fysetc  -I./src/lcd/extui/lib/dgus/hiprecy  -I./src/lcd/extui/lib/dgus/origin  -I./src/lcd/extui/lib/dgus/pandapi  -I./src/lcd/extui/lib/ftdi_eve_touch_ui  -I./src/lcd/extui/lib/ftdi_eve_touch_ui/archim2-flash  -I./src/lcd/extui/lib/ftdi_eve_touch_ui/ftdi_eve_lib  -I./src/lcd/extui/lib/ftdi_eve_touch_ui/ftdi_eve_lib/basic  -I./src/lcd/extui/lib/ftdi_eve_touch_ui/ftdi_eve_lib/extended  -I./src/lcd/extui/lib/ftdi_eve_touch_ui/ftdi_eve_lib/extended/unicode  -I./src/lcd/extui/lib/ftdi_eve_touch_ui/ftdi_eve_lib/extended/unicode/font_bitmaps  -I./src/lcd/extui/lib/ftdi_eve_touch_ui/ftdi_eve_lib/extras  -I./src/lcd/extui/lib/ftdi_eve_touch_ui/language  -I./src/lcd/extui/lib/ftdi_eve_touch_ui/screens  -I./src/lcd/extui/lib/ftdi_eve_touch_ui/theme  -I./src/lcd/extui/lib/mks_ui  -I./src/lcd/HD44780  -I./src/lcd/language  -I./src/lcd/menu  -I./src/lcd/menu/game  -I./src/lcd/utility  -I./src/libs  -I./src/libs/heatshrink  -I./src/libs/L64XX  -I./src/module  -I./src/module/stepper  -I./src/module/thermistor  -I./src/pins  -I./src/pins/esp32  -I./src/pins/linux  -I./src/pins/lpc1768  -I./src/pins/lpc1769  -I./src/pins/mega  -I./src/pins/rambo  -I./src/pins/ramps  -I./src/pins/sam  -I./src/pins/samd  -I./src/pins/sanguino  -I./src/pins/stm32f0  -I./src/pins/stm32f1  -I./src/pins/stm32f4  -I./src/pins/stm32f7  -I./src/pins/teensy2  -I./src/pins/teensy3  -I./src/sd  -I./src/sd/usb_flashdrive  -I./src/sd/usb_flashdrive/lib-uhs2  -I./src/sd/usb_flashdrive/lib-uhs3  -I./src/sd/usb_flashdrive/lib-uhs3/dyn_SWI  -I./src/sd/usb_flashdrive/lib-uhs3/UHS_host  -I./src/sd/usb_flashdrive/lib-uhs3/UHS_host/UHS_BULK_STORAGE  -I./src/sd/usb_flashdrive/lib-uhs3/UHS_host/USB_HOST_SHIELD  -I.  -c -o src/lcd/utility/u8g_virtual_screen.o src/lcd/utility/u8g_virtual_screen.c
stderr:/usr/bin/ld: src/module/configuration_store.o: in function `MarlinSettings::savestderr:()':
configuration_store.cpp:(.text+0x1078): undefined reference to `ZStepperAlign::xy'
/usr/bin/ld: src/module/configuration_store.o: in function `MarlinSettings::_load()':
configuration_store.cpp:(.text+0x2104): undefined reference to `ZStepperAlign::xy'
/usr/bin/ld: src/module/configuration_store.o: in function `MarlinSettings::reset()':
configuration_store.cpp:(.text+0x29c4): undefined reference to `ZStepperAlign::reset_to_default()'
/usr/bin/ld: src/gcode/calibrate/G34_M422.o: in function `GcodeSuite::G34()::{lambda(unsigned char, unsigned char)#1}::operator()(unsigned char, unsigned char) const':
G34_M422.cpp:(.text+0x10c): undefined reference to `ZStepperAlign::xy'
/usr/bin/ld: src/gcode/calibrate/G34_M422.o: in function `GcodeSuite::G34()':
G34_M422.cpp:(.text+0x334): undefined reference to `ZStepperAlign::reset_to_default()'
/usr/bin/ld: G34_M422.cpp:(.text+0x52c): undefined reference to `ZStepperAlign::xy'
/usr/bin/ld: src/gcode/calibrate/G34_M422.o: in function `GcodeSuite::M422()':
G34_M422.cpp:(.text+0xbd8): undefined reference to `ZStepperAlign::reset_to_default()'
/usr/bin/ld: G34_M422.cpp:(.text+0xf60): undefined reference to `ZStepperAlign::xy'
stderr:collect2: error: ld returned 1 exit status
stderr:make: *** [Makefile:40: pi_marlin] Error 1
make: Leaving directory '/home/pi/PandaPI/Marlin2.x/pandapi'
compile failed !stdclose:2compile failed !

markniu, 2020-09-01:
Hi, thanks for report this compile error of ZStepperAlign, I have just fixed and updated it to github. you can update the source code from the compile web page.

EMDM25, 2020-09-01:
Now I have two Problem the first one is that the

1) [BLtouch not deploying when Auto Homing]

2) The Seco one is that I have the sliceengineering Thermistor, I changed the config file to the #67, but it does not show the temp.

EMDM25, 2020-09-01:
Sorry  the thermistor is working just  the bltouch is the one that is not working for me for homing

markniu, 2020-09-02:
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

Check if the BLTOUCH is enabled in the marlin and the connection? and send M280 to test it at first.for example, Push-pin Down(M280 P0 S10) Push-pin Up(M280 P0 S90).
the firmware in the mcu on pandapi only support thermistor of 100k( 3950,NTC..),the temperature value maybe not correct if use other thermistors.

EMDM25, 2020-09-02:
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

EMDM25, 2020-09-02:
that is when you turn the printer

EMDM25, 2020-09-02:
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

EMDM25, 2020-09-02:
but when I send command does not respond.

EMDM25, 2020-09-02:
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

EMDM25, 2020-09-02:
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

markniu, 2020-09-02:
how about send M280 P0 S10   , if the pin can be pushed pin down?

EMDM25, 2020-09-02:
I have tried to send all the command for the bltouch and it didn't work

EMDM25, 2020-09-02:
Here is my Conf file if that can help you, is possible that I did something wrong
[Configuration.zip](https://github.com/markniu/PandaPi/files/5160119/Configuration.zip)

EMDM25, 2020-09-02:
CONFIGURATION.H

/**
 * Marlin 3D Printer Firmware
 * Copyright (c) 2020 MarlinFirmware [https://github.com/MarlinFirmware/Marlin]
 *
 * Based on Sprinter and grbl.
 * Copyright (c) 2011 Camiel Gubbels / Erik van der Zalm
 *
 * This program is free software: you can redistribute it and/or modify
 * it under the terms of the GNU General Public License as published by
 * the Free Software Foundation, either version 3 of the License, or
 * (at your option) any later version.
 *
 * This program is distributed in the hope that it will be useful,
 * but WITHOUT ANY WARRANTY; without even the implied warranty of
 * MERCHANTABILITY or FITNESS FOR A PARTICULAR PURPOSE.  See the
 * GNU General Public License for more details.
 *
 * You should have received a copy of the GNU General Public License
 * along with this program.  If not, see <https://www.gnu.org/licenses/>.
 *
 */
#pragma once

/**
 * Configuration.h
 *
 * Basic settings such as:
 *
 * - Type of electronics
 * - Type of temperature sensor
 * - Printer geometry
 * - Endstop configuration
 * - LCD controller
 * - Extra features
 *
 * Advanced settings can be found in Configuration_adv.h
 *
 */
#define CONFIGURATION_H_VERSION 020006

//===========================================================================
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

Thread 24 (2020-09-20):

Works with RPi 2 B+?

santi19z, 2020-09-20:
The PandaPi board works with Raspberry Pi 2???

markniu, 2020-09-21:
Have not worked with RaspberryPi2, so not recommend

Thread 25 (2020-09-22):

[feature-request] update octoprint to python 3

Moorviper, 2020-09-22:
The last plugin which is shipped with the octopi image which was still only python 2 compatible is now updated.
It would be great if there would be a new base Image with the latest octoprint and python 3.

https://github.com/vitormhenrique/OctoPrint-Enclosure/commit/37796fafbee7b0c19cba7ea8a6a42d119539e0c5

greetings
Daniel

markniu, 2020-09-29:
know a little of the python and octopi code. so I just download the latest octopi img. and replaced the kernel and put the Marlin into it.

Moorviper, 2021-04-04:
closing due to https://github.com/markniu/PandaPi/issues/32

Closed 2021-04-04.

Thread 26 (2020-10-08):

Boot error with Raspberry Pi4 8G

markniu, 2020-10-08:
recovery4.elf not found
  recovery.elf not found
  start4x.elf : is not compatible 0x0

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

markniu, 2020-10-08:
fixed  by replace all the start**.elf file and *.dat file in the boot with the latest from Raspberry Pi.
had update to the newest IMG file    https://drive.google.com/drive/folders/1uaVb2FVFBBJS12u6wuIlql26OMlpzk5T

Closed 2020-10-08.

Thread 27 (2020-12-03):

[feature-request]

Moorviper, 2020-12-03:
Hi after i have seen some Raspberry Pi shields it maybe would be great if a fan mount could be added to get a better cooling of the Raspberry PI.

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

Something like this:
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

Ok maybe routing the traces isn't possible ...
and the PCB gets bigger ...

markniu, 2020-12-03:
That's good idea!it maybe possible.I am considering how to add one fan on top of the motor driver and Pi.

Moorviper, 2020-12-04:
Or to make it easier

only opening above the SOC
(i don't have checked how much the orientation changes between the different raspberries)
and 4 holes to add a 3d printed fan shroud for the fan

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

Thread 28 (2020-12-30):

More information on runout sensor

dsancheznet, 2020-12-30:
Please provide a more detailed information on the runout sensor, since I do not quite understand how to wire it up in version 2.5 of the board. I own this sensor:

https://es.aliexpress.com/item/32969817931.html?spm=a2g0s.9042311.0.0.3cfc63c0WZ4FaY

Which is apparently for an ender printer. Anyway, if I insert filament into the sensor, pins 1 and 3 get shorted.
Where do I have to connect the pins... G + C or G + D or C + D or does it need to provide 3.3V or 5 V to the pins?

Best regards

markniu, 2021-01-04:
connect it to pin G and C,  no need to provide 3.3V or 5V.

dsancheznet, 2021-01-04:
Thank you!

Closed 2021-01-04.

Thread 29 (2021-03-27):

G33 failing consistently

AmEv7Fam, 2021-03-27:
I was able to attach my PandaPi to my Openbeam Kossel Pro, and all that's left is configuration. However, whenever I run G33, it consistently errors out with either "homing failed" (if I don't home first) or "Z probe failed".

Configuration.h:

```
/**
 * Marlin 3D Printer Firmware
 * Copyright (c) 2020 MarlinFirmware [https://github.com/MarlinFirmware/Marlin]
 *
 * Based on Sprinter and grbl.
 * Copyright (c) 2011 Camiel Gubbels / Erik van der Zalm
 *
 * This program is free software: you can redistribute it and/or modify
 * it under the terms of the GNU General Public License as published by
 * the Free Software Foundation, either version 3 of the License, or
 * (at your option) any later version.
 *
 * This program is distributed in the hope that it will be useful,
 * but WITHOUT ANY WARRANTY; without even the implied warranty of
 * MERCHANTABILITY or FITNESS FOR A PARTICULAR PURPOSE.  See the
 * GNU General Public License for more details.
 *
 * You should have received a copy of the GNU General Public License
 * along with this program.  If not, see <https://www.gnu.org/licenses/>.
 *
 */
#pragma once

// #define CONFIG_EXAMPLES_DIR "delta/kossel_pro"

/**
 * Example configuration file for OpenBeam Kossel Pro
 */

/**
 * Configuration.h
 *
 * Basic settings such as:
 *
 * - Type of electronics
 * - Type of temperature sensor
 * - Printer geometry
 * - Endstop configuration
 * - LCD controller
 * - Extra features
 *
 * Advanced settings can be found in Configuration_adv.h
 */
#define CONFIGURATION_H_VERSION 020006

//===========================================================================
//============================= Getting Started =============================
//===========================================================================

/**
 * Here are some standard links for getting your machine calibrated:
 *
 * https://reprap.org/wiki/Calibration
 * https://youtu.be/wAL9d7FgInk
 * http://calculator.josefprusa.cz
 * https://reprap.org/wiki/Triffid_Hunter%27s_Calibration_Guide
 * https://www.thingiverse.com/thing:5573
 * https://sites.google.com/site/repraplogphase/calibration-of-your-reprap
 * https://www.thingiverse.com/thing:298812
 */

//===========================================================================
//============================= DELTA Printer ===============================
//===========================================================================
// For a Delta printer start with one of the configuration files in the
// config/examples/delta directory and customize for your machine.
//

//===========================================================================
//============================= SCARA Printer ===============================
//===========================================================================
// For a SCARA printer start with the configuration files in
// config/examples/SCARA and customize for your machine.
//

// @section info

// Author info of this build printed to the host during boot and M115
#define STRING_CONFIG_H_AUTHOR "(mark, PandaPi marlin  config)" // Who made the changes.
//#define CUSTOM_VERSION_FILE Version.h // Path from the root directory (no quotes)
#define PANDAPI  1    // PandaPi shield for raspberry Pi printer
#define CPU_32_BIT
#define MOTOR_SPEED_CALIBRATE
/**
 * *** VENDORS PLEASE READ ***
 *
 * Marlin allows you to add a custom boot image for Graphical LCDs.
 * With this option Marlin will first show your custom screen followed
 * by the standard Marlin logo with version number and web URL.
 *
 * We encourage you to take advantage of this new feature and we also
 * respectfully request that you retain the unmodified Marlin boot screen.
 */

// Show the Marlin bootscreen on startup. ** ENABLE FOR PRODUCTION **
#define SHOW_BOOTSCREEN

// Show the bitmap in Marlin/_Bootscreen.h on startup.
//#define SHOW_CUSTOM_BOOTSCREEN

// Show the bitmap in Marlin/_Statusscreen.h on the status screen.
//#define CUSTOM_STATUS_SCREEN_IMAGE

// @section machine

/**
 * Select the serial port on the board to use for communication with the host.
 * This allows the connection of wireless adapters (for instance) to non-default port pins.
 * Serial port -1 is the USB emulated serial port, if available.
 * Note: The first serial port (-1 or 0) will always be used by the Arduino bootloader.
 *
 * :[-1, 0, 1, 2, 3, 4, 5, 6, 7]
 */
#define SERIAL_PORT 0

/**
 * Select a secondary serial port on the board to use for communication with the host.
 * :[-1, 0, 1, 2, 3, 4, 5, 6, 7]
 */
#define SERIAL_PORT_2 1

/**
 * This setting determines the communication speed of the printer.
 *
 * 250000 works in most cases, but you might try a lower speed if
 * you commonly experience drop-outs during host printing.
 * You may try up to 1000000 to speed up SD file transfer.
 *
 * :[2400, 9600, 19200, 38400, 57600, 115200, 250000, 500000, 1000000]
 */

#define BAUDRATE 115200
//  PANDAPI
#define BAUDRATE_TNT   115200  // for octoprint serial//  PANDAPI [ 57600, 115200,  500000, 1000000]

//  PANDAPI
#define DGUS_LCD_UI_PANDAPI
#if DISABLED(DGUS_LCD_UI_PANDAPI)
	#define ULTRA_LCD
	#define REPRAP_DISCOUNT_FULL_GRAPHIC_SMART_CONTROLLER
#endif

// @section extruder

// This defines the number of extruders
// :[0, 1, 2, 3, 4, 5, 6, 7, 8]
#define EXTRUDERS 1

//#define MAX31856_PANDAPI
#if ENABLED(MAX31856_PANDAPI)
    // 2, 3, 4 wire
	#define MAX31856_WIRES         2

#endif

// Enable the Bluetooth serial interface on AT90USB devices
//#define BLUETOOTH

// Choose the name from boards.h that matches your setup
#ifndef MOTHERBOARD
  #define MOTHERBOARD BOARD_PANDA_PI//BOARD_RAMPS_14_EFB //  PANDAPI
#endif

// Name displayed in the LCD "Ready" message and Info menu
#define CUSTOM_MACHINE_NAME "Kossel Pro"

// Printer's unique ID, used by some programs to differentiate between machines.
// Choose your own or use a service like https://www.uuidgenerator.net/version4
//#define MACHINE_UUID "00000000-0000-0000-0000-000000000000"

// Generally expected filament diameter (1.75, 2.85, 3.0, ...). Used for Volumetric, Filament Width Sensor, etc.
#define DEFAULT_NOMINAL_FILAMENT_DIA 1.75

// For Cyclops or any "multi-extruder" that shares a single nozzle.
//#define SINGLENOZZLE

// Save and restore temperature and fan speed on tool-change.
// Set standby for the unselected tool with M104/106/109 T...
#if ENABLED(SINGLENOZZLE)
  //#define SINGLENOZZLE_STANDBY_TEMP
  //#define SINGLENOZZLE_STANDBY_FAN
#endif

/**
 * Průša MK2 Single Nozzle Multi-Material Multiplexer, and variants.
 *
 * This device allows one stepper driver on a control board to drive
 * two to eight stepper motors, one at a time, in a manner suitable
 * for extruders.
 *
 * This option only allows the multiplexer to switch on tool-change.
 * Additional options to configure custom E moves are pending.
 */
//#define MK2_MULTIPLEXER
#if ENABLED(MK2_MULTIPLEXER)
  // Override the default DIO selector pins here, if needed.
  // Some pins files may provide defaults for these pins.
  //#define E_MUX0_PIN 40  // Always Required
  //#define E_MUX1_PIN 42  // Needed for 3 to 8 inputs
  //#define E_MUX2_PIN 44  // Needed for 5 to 8 inputs
#endif

/**
 * Průša Multi-Material Unit v2
 *
 * Requires NOZZLE_PARK_FEATURE to park print head in case MMU unit fails.
 * Requires EXTRUDERS = 5
 *
 * For additional configuration see Configuration_adv.h
 */
//#define PRUSA_MMU2

// A dual extruder that uses a single stepper motor
//#define SWITCHING_EXTRUDER
#if ENABLED(SWITCHING_EXTRUDER)
  #define SWITCHING_EXTRUDER_SERVO_NR 0
  #define SWITCHING_EXTRUDER_SERVO_ANGLES { 0, 90 } // Angles for E0, E1[, E2, E3]
  #if EXTRUDERS > 3
    #define SWITCHING_EXTRUDER_E23_SERVO_NR 1
  #endif
#endif

// A dual-nozzle that uses a servomotor to raise/lower one (or both) of the nozzles
//#define SWITCHING_NOZZLE
#if ENABLED(SWITCHING_NOZZLE)
  #define SWITCHING_NOZZLE_SERVO_NR 0
  //#define SWITCHING_NOZZLE_E1_SERVO_NR 1          // If two servos are used, the index of the second
  #define SWITCHING_NOZZLE_SERVO_ANGLES { 0, 90 }   // Angles for E0, E1 (single servo) or lowered/raised (dual servo)
#endif

/**
 * Two separate X-carriages with extruders that connect to a moving part
 * via a solenoid docking mechanism. Requires SOL1_PIN and SOL2_PIN.
 */
//#define PARKING_EXTRUDER

/**
 * Two separate X-carriages with extruders that connect to a moving part
 * via a magnetic docking mechanism using movements and no solenoid
 *
 * project   : https://www.thingiverse.com/thing:3080893
 * movements : https://youtu.be/0xCEiG9VS3k
 *             https://youtu.be/Bqbcs0CU2FE
 */
//#define MAGNETIC_PARKING_EXTRUDER

#if EITHER(PARKING_EXTRUDER, MAGNETIC_PARKING_EXTRUDER)

  #define PARKING_EXTRUDER_PARKING_X { -78, 184 }     // X positions for parking the extruders
  #define PARKING_EXTRUDER_GRAB_DISTANCE 1            // (mm) Distance to move beyond the parking point to grab the extruder
  //#define MANUAL_SOLENOID_CONTROL                   // Manual control of docking solenoids with M380 S / M381

  #if ENABLED(PARKING_EXTRUDER)

    #define PARKING_EXTRUDER_SOLENOIDS_INVERT           // If enabled, the solenoid is NOT magnetized with applied voltage
    #define PARKING_EXTRUDER_SOLENOIDS_PINS_ACTIVE LOW  // LOW or HIGH pin signal energizes the coil
    #define PARKING_EXTRUDER_SOLENOIDS_DELAY 250        // (ms) Delay for magnetic field. No delay if 0 or not defined.
    //#define MANUAL_SOLENOID_CONTROL                   // Manual control of docking solenoids with M380 S / M381

  #elif ENABLED(MAGNETIC_PARKING_EXTRUDER)

    #define MPE_FAST_SPEED      9000      // (mm/min) Speed for travel before last distance point
    #define MPE_SLOW_SPEED      4500      // (mm/min) Speed for last distance travel to park and couple
    #define MPE_TRAVEL_DISTANCE   10      // (mm) Last distance point
    #define MPE_COMPENSATION       0      // Offset Compensation -1 , 0 , 1 (multiplier) only for coupling

  #endif

#endif

/**
 * Switching Toolhead
 *
 * Support for swappable and dockable toolheads, such as
 * the E3D Tool Changer. Toolheads are locked with a servo.
 */
//#define SWITCHING_TOOLHEAD

/**
 * Magnetic Switching Toolhead
 *
 * Support swappable and dockable toolheads with a magnetic
 * docking mechanism using movement and no servo.
 */
//#define MAGNETIC_SWITCHING_TOOLHEAD

/**
 * Electromagnetic Switching Toolhead
 *
 * Parking for CoreXY / HBot kinematics.
 * Toolheads are parked at one edge and held with an electromagnet.
 * Supports more than 2 Toolheads. See https://youtu.be/JolbsAKTKf4
 */
//#define ELECTROMAGNETIC_SWITCHING_TOOLHEAD

#if ANY(SWITCHING_TOOLHEAD, MAGNETIC_SWITCHING_TOOLHEAD, ELECTROMAGNETIC_SWITCHING_TOOLHEAD)
  #define SWITCHING_TOOLHEAD_Y_POS          235         // (mm) Y position of the toolhead dock
  #define SWITCHING_TOOLHEAD_Y_SECURITY      10         // (mm) Security distance Y axis
  #define SWITCHING_TOOLHEAD_Y_CLEAR         60         // (mm) Minimum distance from dock for unobstructed X axis
  #define SWITCHING_TOOLHEAD_X_POS          { 215, 0 }  // (mm) X positions for parking the extruders
  #if ENABLED(SWITCHING_TOOLHEAD)
    #define SWITCHING_TOOLHEAD_SERVO_NR       2         // Index of the servo connector
    #define SWITCHING_TOOLHEAD_SERVO_ANGLES { 0, 180 }  // (degrees) Angles for Lock, Unlock
  #elif ENABLED(MAGNETIC_SWITCHING_TOOLHEAD)
    #define SWITCHING_TOOLHEAD_Y_RELEASE      5         // (mm) Security distance Y axis
    #define SWITCHING_TOOLHEAD_X_SECURITY   { 90, 150 } // (mm) Security distance X axis (T0,T1)
    //#define PRIME_BEFORE_REMOVE                       // Prime the nozzle before release from the dock
    #if ENABLED(PRIME_BEFORE_REMOVE)
      #define SWITCHING_TOOLHEAD_PRIME_MM           20  // (mm)   Extruder prime length
      #define SWITCHING_TOOLHEAD_RETRACT_MM         10  // (mm)   Retract after priming length
      #define SWITCHING_TOOLHEAD_PRIME_FEEDRATE    300  // (mm/min) Extruder prime feedrate
      #define SWITCHING_TOOLHEAD_RETRACT_FEEDRATE 2400  // (mm/min) Extruder retract feedrate
    #endif
  #elif ENABLED(ELECTROMAGNETIC_SWITCHING_TOOLHEAD)
    #define SWITCHING_TOOLHEAD_Z_HOP          2         // (mm) Z raise for switching
  #endif
#endif

/**
 * "Mixing Extruder"
 *   - Adds G-codes M163 and M164 to set and "commit" the current mix factors.
 *   - Extends the stepping routines to move multiple steppers in proportion to the mix.
 *   - Optional support for Repetier Firmware's 'M164 S<index>' supporting virtual tools.
 *   - This implementation supports up to two mixing extruders.
 *   - Enable DIRECT_MIXING_IN_G1 for M165 and mixing in G1 (from Pia Taubert's reference implementation).
 */
//#define MIXING_EXTRUDER
#if ENABLED(MIXING_EXTRUDER)
  #define MIXING_STEPPERS 2        // Number of steppers in your mixing extruder
  #define MIXING_VIRTUAL_TOOLS 16  // Use the Virtual Tool method with M163 and M164
  //#define DIRECT_MIXING_IN_G1    // Allow ABCDHI mix factors in G1 movement commands
  //#define GRADIENT_MIX           // Support for gradient mixing with M166 and LCD
  #if ENABLED(GRADIENT_MIX)
    //#define GRADIENT_VTOOL       // Add M166 T to use a V-tool index as a Gradient alias
  #endif
#endif

// Offset of the extruders (uncomment if using more than one and relying on firmware to position when changing).
// The offset has to be X=0, Y=0 for the extruder 0 hotend (default extruder).
// For the other hotends it is their distance from the extruder 0 hotend.
//#define HOTEND_OFFSET_X { 0.0, 20.00 } // (mm) relative X-offset for each nozzle
//#define HOTEND_OFFSET_Y { 0.0, 5.00 }  // (mm) relative Y-offset for each nozzle
//#define HOTEND_OFFSET_Z { 0.0, 0.00 }  // (mm) relative Z-offset for each nozzle

// @section machine

/**
 * Power Supply Control
 *
 * Enable and connect the power supply to the PS_ON_PIN.
 * Specify whether the power supply is active HIGH or active LOW.
 */
//#define PSU_CONTROL
//#define PSU_NAME "Power Supply"

#if ENABLED(PSU_CONTROL)
  #define PSU_ACTIVE_HIGH false     // Set 'false' for ATX, 'true' for X-Box

  //#define PSU_DEFAULT_OFF         // Keep power off until enabled directly with M80
  //#define PSU_POWERUP_DELAY 250   // (ms) Delay for the PSU to warm up to full power

  //#define AUTO_POWER_CONTROL      // Enable automatic control of the PS_ON pin
  #if ENABLED(AUTO_POWER_CONTROL)
    #define AUTO_POWER_FANS         // Turn on PSU if fans need power
    #define AUTO_POWER_E_FANS
    #define AUTO_POWER_CONTROLLERFAN
    #define AUTO_POWER_CHAMBER_FAN
    //#define AUTO_POWER_E_TEMP        50 // (°C) Turn on PSU over this temperature
    //#define AUTO_POWER_CHAMBER_TEMP  30 // (°C) Turn on PSU over this temperature
    #define POWER_TIMEOUT 30
  #endif
#endif

//===========================================================================
//============================= Thermal Settings ============================
//===========================================================================
// @section temperature

/**
 * --NORMAL IS 4.7kohm PULLUP!-- 1kohm pullup can be used on hotend sensor, using correct resistor and table
 *
 * Temperature sensors available:
 *
 *    -5 : PT100 / PT1000 with MAX31865 (only for sensors 0-1)
 *    -3 : thermocouple with MAX31855 (only for sensors 0-1)
 *    -2 : thermocouple with MAX6675 (only for sensors 0-1)
 *    -4 : thermocouple with AD8495
 *    -1 : thermocouple with AD595
 *     0 : not used
 *     1 : 100k thermistor - best choice for EPCOS 100k (4.7k pullup)
 *   331 : (3.3V scaled thermistor 1 table for MEGA)
 *   332 : (3.3V scaled thermistor 1 table for DUE)
 *     2 : 200k thermistor - ATC Semitec 204GT-2 (4.7k pullup)
 *   202 : 200k thermistor - Copymaster 3D
 *     3 : Mendel-parts thermistor (4.7k pullup)
 *     4 : 10k thermistor !! do not use it for a hotend. It gives bad resolution at high temp. !!
 *     5 : 100K thermistor - ATC Semitec 104GT-2/104NT-4-R025H42G (Used in ParCan, J-Head, and E3D) (4.7k pullup)
 *   501 : 100K Zonestar (Tronxy X3A) Thermistor
 *   502 : 100K Zonestar Thermistor used by hot bed in Zonestar Průša P802M
 *   512 : 100k RPW-Ultra hotend thermistor (4.7k pullup)
 *     6 : 100k EPCOS - Not as accurate as table 1 (created using a fluke thermocouple) (4.7k pullup)
 *     7 : 100k Honeywell thermistor 135-104LAG-J01 (4.7k pullup)
 *    71 : 100k Honeywell thermistor 135-104LAF-J01 (4.7k pullup)
 *     8 : 100k 0603 SMD Vishay NTCS0603E3104FXT (4.7k pullup)
 *     9 : 100k GE Sensing AL03006-58.2K-97-G1 (4.7k pullup)
 *    10 : 100k RS thermistor 198-961 (4.7k pullup)
 *    11 : 100k beta 3950 1% thermistor (Used in Keenovo AC silicone mats and most Wanhao i3 machines) (4.7k pullup)
 *    12 : 100k 0603 SMD Vishay NTCS0603E3104FXT (4.7k pullup) (calibrated for Makibox hot bed)
 *    13 : 100k Hisens 3950  1% up to 300°C for hotend "Simple ONE " & "Hotend "All In ONE"
 *    15 : 100k thermistor calibration for JGAurora A5 hotend
 *    18 : ATC Semitec 204GT-2 (4.7k pullup) Dagoma.Fr - MKS_Base_DKU001327
 *    20 : Pt100 with circuit in the Ultimainboard V2.x with 5v excitation (AVR)
 *    21 : Pt100 with circuit in the Ultimainboard V2.x with 3.3v excitation (STM32 \ LPC176x....)
 *    22 : 100k (hotend) with 4.7k pullup to 3.3V and 220R to analog input (as in GTM32 Pro vB)
 *    23 : 100k (bed) with 4.7k pullup to 3.3v and 220R to analog input (as in GTM32 Pro vB)
 *    30 : Kis3d Silicone heating mat 200W/300W with 6mm precision cast plate (EN AW 5083) NTC100K / B3950 (4.7k pullup)
 *   201 : Pt100 with circuit in Overlord, similar to Ultimainboard V2.x
 *    60 : 100k Maker's Tool Works Kapton Bed Thermistor beta=3950
 *    61 : 100k Formbot / Vivedino 3950 350C thermistor 4.7k pullup
 *    66 : 4.7M High Temperature thermistor from Dyze Design
 *    67 : 450C thermistor from SliceEngineering
 *    70 : the 100K thermistor found in the bq Hephestos 2
 *    75 : 100k Generic Silicon Heat Pad with NTC 100K MGB18-104F39050L32 thermistor
 *    99 : 100k thermistor with a 10K pull-up resistor (found on some Wanhao i3 machines)
 *
 *       1k ohm pullup tables - This is atypical, and requires changing out the 4.7k pullup for 1k.
 *                              (but gives greater accuracy and more stable PID)
 *    51 : 100k thermistor - EPCOS (1k pullup)
 *    52 : 200k thermistor - ATC Semitec 204GT-2 (1k pullup)
 *    55 : 100k thermistor - ATC Semitec 104GT-2 (Used in ParCan & J-Head) (1k pullup)
 *
 *  1047 : Pt1000 with 4k7 pullup (E3D)
 *  1010 : Pt1000 with 1k pullup (non standard)
 *   147 : Pt100 with 4k7 pullup
 *   110 : Pt100 with 1k pullup (non standard)
 *
 *  1000 : Custom - Specify parameters in Configuration_adv.h
 *
 *         Use these for Testing or Development purposes. NEVER for production machine.
 *   998 : Dummy Table that ALWAYS reads 25°C or the temperature defined below.
 *   999 : Dummy Table that ALWAYS reads 100°C or the temperature defined below.
 */
#define TEMP_SENSOR_0 13
#if ENABLED(SINGLENOZZLE)//  PANDAPI
	#define TEMP_SENSOR_1 0
#else
	#if EXTRUDERS > 1 //  PANDAPI
		#define TEMP_SENSOR_1 13
	#endif
#endif
#define TEMP_SENSOR_2 0
#define TEMP_SENSOR_3 0
#define TEMP_SENSOR_4 0
#define TEMP_SENSOR_5 0
#define TEMP_SENSOR_6 0
#define TEMP_SENSOR_7 0
#define TEMP_SENSOR_BED 13
#define TEMP_SENSOR_PROBE 0
#define TEMP_SENSOR_CHAMBER 0

// Dummy thermistor constant temperature readings, for use with 998 and 999
#define DUMMY_THERMISTOR_998_VALUE 25
#define DUMMY_THERMISTOR_999_VALUE 100

// Use temp sensor 1 as a redundant sensor with sensor 0. If the readings
// from the two sensors differ too much the print will be aborted.
//#define TEMP_SENSOR_1_AS_REDUNDANT
#define MAX_REDUNDANT_TEMP_SENSOR_DIFF 10

#define TEMP_RESIDENCY_TIME     10  // (seconds) Time to wait for hotend to "settle" in M109
#define TEMP_WINDOW              1  // (°C) Temperature proximity for the "temperature reached" timer
#define TEMP_HYSTERESIS          3  // (°C) Temperature proximity considered "close enough" to the target

#define TEMP_BED_RESIDENCY_TIME  0  // (seconds) Time to wait for bed to "settle" in M190
#define TEMP_BED_WINDOW          1  // (°C) Temperature proximity for the "temperature reached" timer
#define TEMP_BED_HYSTERESIS      3  // (°C) Temperature proximity considered "close enough" to the target

// Below this temperature the heater will be switched off
// because it probably indicates a broken thermistor wire.
#define HEATER_0_MINTEMP   5
#define HEATER_1_MINTEMP   5
#define HEATER_2_MINTEMP   5
#define HEATER_3_MINTEMP   5
#define HEATER_4_MINTEMP   5
#define HEATER_5_MINTEMP   5
#define HEATER_6_MINTEMP   5
#define HEATER_7_MINTEMP   5
#define BED_MINTEMP        5

// Above this temperature the heater will be switched off.
// This can protect components from overheating, but NOT from shorts and failures.
// (Use MINTEMP for thermistor short/failure protection.)
#define HEATER_0_MAXTEMP 275
#define HEATER_1_MAXTEMP 275
#define HEATER_2_MAXTEMP 275
#define HEATER_3_MAXTEMP 275
#define HEATER_4_MAXTEMP 275
#define HEATER_5_MAXTEMP 275
#define HEATER_6_MAXTEMP 275
#define HEATER_7_MAXTEMP 275
#define BED_MAXTEMP      150

//===========================================================================
//============================= PID Settings ================================
//===========================================================================
// PID Tuning Guide here: https://reprap.org/wiki/PID_Tuning

// Comment the following line to disable PID and enable bang-bang.
#define PIDTEMP
#define BANG_MAX 255     // Limits current to nozzle while in bang-bang mode; 255=full current
#define PID_MAX BANG_MAX // Limits current to nozzle while PID is active (see  PID_FUNCTIONAL_RANGE below); 255=full current
#define PID_K1 0.95      // Smoothing factor within any PID loop

#if ENABLED(PIDTEMP)
  //#define PID_EDIT_MENU         // Add PID editing to the "Advanced Settings" menu. (~700 bytes of PROGMEM)
  //#define PID_AUTOTUNE_MENU     // Add PID auto-tuning to the "Advanced Settings" menu. (~250 bytes of PROGMEM)
  //#define PID_PARAMS_PER_HOTEND // Uses separate PID parameters for each extruder (useful for mismatched extruders)
                                  // Set/get with gcode: M301 E[extruder number, 0-2]

  // Kossel Pro
  #if ENABLED(PID_PARAMS_PER_HOTEND)
    // Specify between 1 and HOTENDS values per array.
    // If fewer than EXTRUDER values are provided, the last element will be repeated.
    #define DEFAULT_Kp_LIST {  19.30,  19.30 }
    #define DEFAULT_Ki_LIST {   3.51,   3.51 }
    #define DEFAULT_Kd_LIST {  26.56,  26.56 }
  #else
    #define DEFAULT_Kp  19.30
    #define DEFAULT_Ki   3.51
    #define DEFAULT_Kd  26.56
  #endif
#endif // PIDTEMP

//===========================================================================
//====================== PID > Bed Temperature Control ======================
//===========================================================================

/**
 * PID Bed Heating
 *
 * If this option is enabled set PID constants below.
 * If this option is disabled, bang-bang will be used and BED_LIMIT_SWITCHING will enable hysteresis.
 *
 * The PID frequency will be the same as the extruder PWM.
 * If PID_dT is the default, and correct for the hardware/configuration, that means 7.689Hz,
 * which is fine for driving a square wave into a resistive load and does not significantly
 * impact FET heating. This also works fine on a Fotek SSR-10DA Solid State Relay into a 250W
 * heater. If your configuration is significantly different than this and you don't understand
 * the issues involved, don't use bed PID until someone else verifies that your hardware works.
 */
//#define PIDTEMPBED

//#define BED_LIMIT_SWITCHING

/**
 * Max Bed Power
 * Applies to all forms of bed control (PID, bang-bang, and bang-bang with hysteresis).
 * When set to any value below 255, enables a form of PWM to the bed that acts like a divider
 * so don't use it unless you are OK with PWM on your bed. (See the comment on enabling PIDTEMPBED)
 */
#define MAX_BED_POWER 255 // limits duty cycle to bed; 255=full current

#if ENABLED(PIDTEMPBED)
  //#define MIN_BED_POWER 0
  //#define PID_BED_DEBUG // Sends debug data to the serial port.

  // Kossel Pro heated bed plate with borosilicate glass
  // from pidautotune (M303 E-1 S60 C8)
  #define DEFAULT_bedKp 370.25
  #define DEFAULT_bedKi 62.77
  #define DEFAULT_bedKd 545.98

  // FIND YOUR OWN: "M303 E-1 C8 S90" to run autotune on the bed at 90 degreesC for 8 cycles.
#endif // PIDTEMPBED

#if EITHER(PIDTEMP, PIDTEMPBED)
  //#define PID_DEBUG             // Sends debug data to the serial port. Use 'M303 D' to toggle activation.
  //#define PID_OPENLOOP          // Puts PID in open loop. M104/M140 sets the output power from 0 to PID_MAX
  //#define SLOW_PWM_HEATERS      // PWM with very low frequency (roughly 0.125Hz=8s) and minimum state time of approximately 1s useful for heaters driven by a relay
  #define PID_FUNCTIONAL_RANGE 10 // If the temperature difference between the target temperature and the actual temperature
                                  // is more than PID_FUNCTIONAL_RANGE then the PID will be shut off and the heater will be set to min/max.
#endif

// @section extruder

/**
 * Prevent extrusion if the temperature is below EXTRUDE_MINTEMP.
 * Add M302 to set the minimum extrusion temperature and/or turn
 * cold extrusion prevention on and off.
 *
 * *** IT IS HIGHLY RECOMMENDED TO LEAVE THIS OPTION ENABLED! ***
 */
#define PREVENT_COLD_EXTRUSION
#define EXTRUDE_MINTEMP 170

/**
 * Prevent a single extrusion longer than EXTRUDE_MAXLENGTH.
 * Note: For Bowden Extruders make this large enough to allow load/unload.
 */
#define PREVENT_LENGTHY_EXTRUDE
#define EXTRUDE_MAXLENGTH 200

//===========================================================================
//======================== Thermal Runaway Protection =======================
//===========================================================================

/**
 * Thermal Protection provides additional protection to your printer from damage
 * and fire. Marlin always includes safe min and max temperature ranges which
 * protect against a broken or disconnected thermistor wire.
 *
 * The issue: If a thermistor falls out, it will report the much lower
 * temperature of the air in the room, and the the firmware will keep
 * the heater on.
 *
 * If you get "Thermal Runaway" or "Heating failed" errors the
 * details can be tuned in Configuration_adv.h
 */

#define THERMAL_PROTECTION_HOTENDS // Enable thermal protection for all extruders
#define THERMAL_PROTECTION_BED     // Enable thermal protection for the heated bed
#define THERMAL_PROTECTION_CHAMBER // Enable thermal protection for the heated chamber

//===========================================================================
//============================= Mechanical Settings =========================
//===========================================================================

// @section machine

// Enable one of the options below for CoreXY, CoreXZ, or CoreYZ kinematics,
// either in the usual order or reversed
//#define COREXY
//#define COREXZ
//#define COREYZ
//#define COREYX
//#define COREZX
//#define COREZY
//#define MARKFORGED_XY  // MarkForged. See https://reprap.org/forum/read.php?152,504042

//===========================================================================
//============================== Delta Settings =============================
//===========================================================================
// Enable DELTA kinematics and most of the default configuration for Deltas
#define DELTA

#if ENABLED(DELTA)

  // Make delta curves from many straight lines (linear interpolation).
  // This is a trade-off between visible corners (not enough segments)
  // and processor overload (too many expensive sqrt calls).
  #define DELTA_SEGMENTS_PER_SECOND 160

  // After homing move down to a height where XY movement is unconstrained
  //#define DELTA_HOME_TO_SAFE_ZONE

  // Delta calibration menu
  // uncomment to add three points calibration menu option.
  // See http://minow.blogspot.com/index.html#4918805519571907051
  //#define DELTA_CALIBRATION_MENU

  // uncomment to add G33 Delta Auto-Calibration (Enable EEPROM_SETTINGS to store results)
  #define DELTA_AUTO_CALIBRATION

  // NOTE NB all values for DELTA_* values MUST be floating point, so always have a decimal point in them

  #if ENABLED(DELTA_AUTO_CALIBRATION)
    // set the default number of probe points : n*n (1 -> 7)
    #define DELTA_CALIBRATION_DEFAULT_POINTS 4
  #endif

  #if EITHER(DELTA_AUTO_CALIBRATION, DELTA_CALIBRATION_MENU)
    // Set the steprate for papertest probing
    #define PROBE_MANUALLY_STEP 0.05      // (mm)
  #endif

  // Print surface diameter/2 minus unreachable space (avoid collisions with vertical towers).
  #define DELTA_PRINTABLE_RADIUS 127.0    // (mm)

  // Center-to-center distance of the holes in the diagonal push rods.
  #define DELTA_DIAGONAL_ROD 301.0        // (mm)

  // Distance between bed and nozzle Z home position
  #define DELTA_HEIGHT 258.00             // (mm) Get this value from G33 auto calibrate

  #define DELTA_ENDSTOP_ADJ { 0.0, 0.0, 0.0 } // Get these values from G33 auto
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

Thread 30 (2021-03-30):

[suggestion/question] Compute Module/CM4

NickSlash, 2021-03-30:
I've never used the compute module(s) and it's virtually impossible to get the latest CM4 at the minute but they seen like a good fit for this?

It would mean extra components on your board for the io you lose from the full size pi but youd also save a bit of space too and the soc moves back to the top which would make cooling easier.

No idea how complicated implementing something like this is and I guess most people have spare pi's and not compute modules so would add more expense but still.

Just a thought.

Moorviper, 2021-04-01:
In general the CM are a great idea...
But they change the socket too often so it makes no sense to use them.

A normal rpi with the pi hat is still a better solution in the long run.

burk80, 2021-05-07:
Ive been thinking of playing with this as a fun project .. if we get a few people with cm4 to test it maybe mark can double check the cad Files?

Thread 31 (2021-03-30):

[support] pandaPI V2.5 - Sensorless homing

adepier, 2021-03-30:
I cant make sensorless homing working with Pandapi v2.5, RaspberryPi4, TMC2209... could you share your working configuration.h and Configuration_adv.h file to compare? or update the doc, giving a troubleshooting procedure? thanks here are my files...
[Configuration.zip](https://github.com/markniu/PandaPi/files/6230011/Configuration.zip)

markniu, 2021-04-01:
you can try to change value of the sensitivity  X_STALL_SENSITIVITY Y_STALL_SENSITIVITY, different motors may have different current and sensitivity.and do not forgot to unplug the endstops.

adepier, 2021-04-01:
That's a good idea, bit still doesn't work... when I send M122, I see that TMC  is disable and stealthChop is disable
any other idea?
thanks
```
Send: M122
Recv: 		X	Y	Z	E
Recv: Address		0	1	2	3
Recv: Enabled		false	false	false	false
Recv: Set current	800	600	400	800
Recv: RMS current	1436	1049	718	1436
Recv: MAX current	2025	1479	1012	2025
Recv: Run current	25/31	18/31	12/31	25/31
Recv: Hold current	12/31	9/31	6/31	12/31
Recv: CS actual	0/31	0/31	0/31	0/31
Recv: PWM scale
Recv: vsense		0=.325	0=.325	0=.325	0=.325
Recv: stealthChop	false	false	false	false
Recv: msteps		256	256	256	256
Recv: tstep		0	0	0	0
Recv: PWM thresh.	1581	1581	2635	2668
Recv: [mm/s]		100	100	3	30
Recv: OT prewarn	false	false	false	false
Recv: pwm scale sum	0	0	0	0
Recv: pwm scale auto	0	0	0	0
Recv: pwm offset auto	0	0	0	0
Recv: pwm grad auto	0	0	0	0
Recv: off time	0	0	0	0
Recv: blank time	16	16	16	16
Recv: hysteresis
Recv:  -end		-3	-3	-3	-3
Recv:  -start		1	1	1	1
Recv: Stallguard thrs	0	0	0	0
Recv: uStep count	0	0	0	0
Recv: DRVSTATUS	X	Y	Z	E
Recv: sg_result	0	0	0	0
Recv: stst		*	*	*	*
Recv: olb
Recv: ola
Recv: s2gb
Recv: s2ga
Recv: otpw
Recv: ot
Recv: 157C
Recv: 150C
Recv: 143C
Recv: 120C
Recv: s2vsa
Recv: s2vsb
Recv: Driver registers:
Recv: 		X	0x00:00:00:00	 Bad response!
Recv: 		Y	0x00:00:00:00	 Bad response!
Recv: 		Z	0x00:00:00:00	 Bad response!
Recv: 		E	0x00:00:00:00	 Bad response!
Recv:
Recv:
Recv: Testing X connection... Error: All LOW
Recv: Testing Y connection... Error: All LOW
Recv: Testing Z connection... Error: All LOW
Recv: Testing E connection... Error: All LOW
Recv: ok
Recv:
```

markniu, 2021-04-03:
The reason of this TMC Error message is that with write only access to TMC, and there is no RXD connection in the hardware. So that's normal.https://github.com/markniu/PandaPi/wiki/How-to-run-TMC2209-with-UART-mode-(V2.0-2.5)
but still no idea why it does not work in your side!

Thread 32 (2021-04-01):

OctoPrint - Python 3?

jneilliii, 2021-04-01:
Is the current flashable img files for PandaPi using OctoPrint in python 2 or python 3 venv?

Moorviper, 2021-04-01:
i am currently downloading the latest image and check

Moorviper, 2021-04-01:
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
nah still python2

Moorviper, 2021-04-04:
I built an octopi 0.18 image with the old 4.x rt kernel.
I had problems with haproxy.
I built the 5.4 kernel manually and will test it tomorrow.

Moorviper, 2021-04-05:
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

It boots. Next stepp marlin ...

Moorviper, 2021-04-07:
ready to use octopi 0.18 image with 5.10.25
http://octopi.pandapi.org/octopi0.18rt.img.zip
plain 0.18 image with kernel, overlays, modules working.

markniu, 2021-04-07:
great work!  does this work for both PI3 and PI4 ?

Moorviper, 2021-04-07:
i can't test it. I only have 2 raspberry pi 3+
I never needed a pi4.

Thread 33 (2021-04-01):

Wired network support on Pi 3B+?

larskotthoff, 2021-04-01:
I can't get the wired networking interface to work with the latest PandaPi 2.5 image on a Raspberry Pi 3B+. The interface does not show up, nor is there anything in the logs indicating that is has been recognised. `lshw` shows the position on the USB bus as "unassigned".

Is support for the wired ethernet interface included in the kernel?

Moorviper, 2021-04-01:
I flashed the PandaPi3_20210320.img image today and it worked fine on a 3b+
i only had to extract it with keka instead of the normal mac os extractor.
the only downside was that you coudn't update octoprint anymore because the image is based on octoprint 0.16 which used python2 which is EOL since the beginning of 2020.

Have you edited any config file ?
If you boot it without any edits it should work just fine.

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

I will try to build an octopi 0.18 image with a 5.4.x real time kernel tomorrow...

larskotthoff, 2021-04-02:
Thanks, I didn't edit any configuration files, just copied the image to the SD card (using `dd` on Linux) and booted. The wired network was working before (running octopi for a different printer) and seems to be working in the sense that I get a green light when I plug in the network cable. I just don't get anything in the system itself that indicates that the network port has been recognized.

markniu, 2021-04-03:
please try this new[ img file](https://drive.google.com/file/d/1G6Lvu28NoxyoVsndvDV1vUB7dHU1NDYO/view?usp=sharing), RT kerenl 64bit for raspberryPi3B, based on [albebert](https://github.com/albebert/pandapi/wiki/How-to-Flash-img-&-WIFI-setup) ,ethernet enabled.

larskotthoff, 2021-04-03:
Works, thank you!

Closed 2021-04-03.

Thread 35 (2021-07-26):

Program porting process

YL-martin, 2021-07-26:
This is great. I have already purchased this motherboard. This firmware can take full advantage of the many software ecosystems of the Raspberry Pi. Can the author describe the process of porting the Marlin firmware to the Raspberry Pi in detail or briefly? Can better facilitate our secondary development on the above

Moorviper, 2021-07-26:
There is no port necessary.
Marlin can run on linux machines.
https://twitter.com/MarlinFirmware/status/1388463841210667010?s=20

markniu, 2021-07-27:
There are comments "PANDAPI" in each of the code that need to change or add.

markniu, 2021-07-27:
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

 that's great! have not try that, looking forward it!

Thread 36 (2021-09-25):

PandaPI with Anet LCD12864 does not work

Egbert51, 2021-09-25:
In the PandaPI Facebook group I reported a problem with the control of the LCD that I use on my Anet. It concerns the display: LCD12864 BL - ST7920 - serial mode. Mark has already made a number of suggestions, but they have not led to a solution. Mark even ordered an LCD to investigate what the problem is. Great service!!!! Because Github seems like a better place for this problem, this issue was created. If not correct, please let me know. I wonder if more people recognize this problem and maybe already have a solution for it. Am really curious.
The buttons and beeper both work. The LCD display shows blue light, but no information. LCD display has been tested on the Anet and works fine there. The connect LCD_RS, LCD_EN and LCD_D4 connected in different ways. Result remains the same. Does anyone know the definition of RS (Register Select/ Chip Select, D4 (Master Out Slave In/R/W) and EN (Enable/serial clock). See also the info in the Facebook group.

Moorviper, 2021-10-06:
the display needs: . "U8glib", "U8g2", "U8g2 Adafruit"

And try this in the config:
#define ANET_FULL_GRAPHICS_LCD
#define ST7920_DELAY_1 DELAY_NS(125)
#define ST7920_DELAY_2 DELAY_NS(125)
#define ST7920_DELAY_3 DELAY_NS(125)

Thread 40 (2022-01-05):

Design choice question

kpishere, 2022-01-05:
Hi, I really like the intent of this project!

Question:  Why the STM32?  Is it for ease of compatibility with other projects?

I'm inclined to have a Pi Zero ONLY be the controller for a 3D printer with an RTOS system on it and a couple of external chips to give more ports on SPI bus and A/D converters for thermistors on I2C bus.

Found this project in doing a "what exists already" search.

I looks like that was your intent too but you've compromised for sake of incorporating other existing projects. Is my understanding correct there?

markniu, 2022-01-06:
Hi,the reason of using stm32 is that the printer needs external ADC and more gpio control for FAN and heater at begin. use i2c ADC as you said is OK too. and then I found with stm32 users can run more software like klipper which is popular too in 3d printer.<html>
<head>
    <meta http-equiv="Content-Type" content="text/html; charset=UTF-8">
</head>
<body>
<br/><br/><br/><div class="ntes-mailmaster-quote" style="padding-top: 1px; padding-bottom: 1px" >
    <div style=" margin-top: 2em; margin-bottom: 1em; font-size: 14px; line-height: 1.25; color: #78787a; " >---- 回复的原邮件 ----</div>
    <div style=" margin-bottom: 1em; font-size: 12px; line-height: 1.25; color: #232324; padding: 0.5em 0.25em; border-radius: 0.67em; background-color: #f0f0f0; " >
        <table width="100%" cellpadding="0" cellspacing="9" border="0">
            <tr>
                <td valign="top" style=" width: 4.25em; font-size: 12px; line-height: 1.25; color: #78787a; " >
                    发件人
                </td>
                <td valign="top" style=" font-size: 12px; line-height: 1.25; color: #232324; word-break: break-all; " >
                    <a class="mail-from" style="text-decoration:none;color:#0886e8;" ***@***.******@***.***&gt;</a>
                </td>
            </tr>
            <tr>
                <td valign="top" style=" width: 4.25em; font-size: 12px; line-height: 1.25; color: #78787a; " >
                    日期
                </td>
                <td class="mail-date" valign="top" style=" font-size: 12px; line-height: 1.25; color: #232324; word-break: break-all; " >
                    2022年01月06日 00:44
                </td>
            </tr>
            <tr style="">
                <td valign="top" style=" width: 4.25em; font-size: 12px; line-height: 1.25; color: #78787a; " >
                    收件人
                </td>
                <td valign="top" style=" font-size: 12px; line-height: 1.25; color: #232324; word-break: break-all; " >
                    <a class="mail-to" style="text-decoration:none;color:#0886e8;" ***@***.******@***.***&gt;</a>
                </td>
            </tr>
            <tr style="">
                <td valign="top" style=" width: 4.25em; font-size: 12px; line-height: 1.25; color: #78787a; " >
                    抄送至
                </td>
                <td valign="top" style=" font-size: 12px; line-height: 1.25; color: #232324; word-break: break-all; " >
                    <a class="mail-cc" style="text-decoration:none;color:#0886e8;" ***@***.******@***.***&gt;</a>
                </td>
            </tr>
            <tr>
                <td valign="top" style=" width: 4.25em; font-size: 12px; line-height: 1.25; color: #78787a; " >
                    主题
                </td>
                <td class="mail-subject" valign="top" style=" font-size: 12px; line-height: 1.25; color: #232324; word-break: break-all; " >
                    [markniu/PandaPi] Design choice question (Issue #40)
                </td>
            </tr>
        </table>
    </div>
    <div>
<p dir="auto">Hi, I really like the intent of this project!</p>
<p dir="auto">Question:  Why the STM32?  Is it for ease of compatibility with other projects?</p>
<p dir="auto">I'm inclined to have a Pi Zero ONLY be the controller for a 3D printer with an RTOS system on it and a couple of external chips to give more ports on SPI bus and A/D converters for thermistors on I2C bus.</p>
<p dir="auto">Found this project in doing a "what exists already" search.</p>
<p dir="auto">I looks like that was your intent too but you've compromised for sake of incorporating other existing projects. Is my understanding correct there?</p>

<p style="font-size:small;-webkit-text-size-adjust:none;color:#666;">&mdash;<br />Reply to this email directly, <a href="https://github.com/markniu/PandaPi/issues/40">view it on GitHub</a>, or <a href="https://github.com/notifications/unsubscribe-auth/ADJ4QLHDWCFW3SAVRJBQCX3UURYNHANCNFSM5LKLBBPA">unsubscribe</a>.<br />Triage notifications on the go with GitHub Mobile for <a href="https://apps.apple.com/app/apple-store/id1477376905?ct=notification-email&amp;mt=8&amp;pt=524675">iOS</a> or <a href="https://play.google.com/store/apps/details?id=com.github.android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">Android</a>.
<br />You are receiving this because you are subscribed to this thread.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<span style="color: transparent; font-size: 0; display: none; visibility: hidden; overflow: hidden; opacity: 0; width: 0; height: 0; max-width: 0; max-height: 0; mso-hide: all">Message ID: <span>&lt;markniu/PandaPi/issues/40</span><span>@</span><span>github</span><span>.</span><span>com&gt;</span></span></p>
<script type="application/ld+json">[
{
***@***.***": "http://schema.org",
***@***.***": "EmailMessage",
"potentialAction": {
***@***.***": "ViewAction",
"target": "https://github.com/markniu/PandaPi/issues/40",
"url": "https://github.com/markniu/PandaPi/issues/40",
"name": "View Issue"
},
"description": "View this Issue on GitHub",
"publisher": {
***@***.***": "Organization",
"name": "GitHub",
"url": "https://github.com"
}
}
]</script></div>
</div>
</body>
</html>

Thread 41 (2022-02-02):

Error on compiling: expected unqualified-id before numeric constant

AmEv7Fam, 2022-02-02:
Upon trying to compile the latest build, I get this error:

```C++
stderr:In file included from /usr/include/aarch64-linux-gnu/bits/fcntl.h:61,
                 from /usr/include/fcntl.h:35,
                 from src/MarlinCore.cpp:63:
src/sd/SdBaseFile.h: At global scope:
src/sd/SdBaseFile.h:51:15: error: expected unqualified-id before numeric constant
               O_RDONLY = O_READ,                // open() oflag - same as O_IN
               ^~~~~~~~
```

A quick google search brought up [this](https://github.com/espressif/arduino-esp32/issues/82), which suggest that it may be a conflict between Wi-Fi and SD libraries... which we may not need???

Thread 42 (2022-05-31):

unused PWM output signal

GHubensG, 2022-05-31:
hello, i can't find a forum to ask my question so i put it here.

im thinking about implementing the PandaPi for my lasercutter because my SKR board with a 32bit proccesor can't handle the amount of gcode i'm trying to send when lasering an image in grayscale.

The laser needs a PWM signal for control. i saw in the marlin file [pins_PANDA_PI.h](https://github.com/markniu/PandaPi/blob/master/Marlin2.x/pandapi/pins_PANDA_PI.h) a Servo pin on pin 255// 0xBE (this was not writen down in the documentation)

is it possible to use this pin? or is there another way i can get an analog output? i don't want to use a fan pin because this will get limited by the STM32 processor i think.

my setup:
2 Nema23 stepper in CoreXY setup with 4 proximity sensors for XY-min&max. i'm Controlling the laser with M3 S1-S255 and M5 S0 commands from marlin.

rndsumgen, 2022-06-07:
https://marlinfw.org/docs/configuration/2.0.9/laser_spindle.html

I was looking through the same file for the same thing for the same reasons. Noticed it missing curious for a response.  Would love to see/hear about it having the ability to work on CNC/Laser/Extruder all out of the box. https://marlinfw.org/docs/configuration/2.0.9/laser_spindle.html goes into details about setting it up but PandaPi seems different.

I'm guessing pin 255 is probably a software defined PWM pin?  That's not normal in marlin.

```
#define HEATER_1_PIN     255
#define HEATER_BED_PIN   255
#define TEMP_0_PIN       255
#define TEMP_1_PIN       255
#define TEMP_BED_PIN     255
#define TEMP_BOARD_PIN   255

#define FAN_PIN         255
#define FAN1_PIN         255
#define FAN2_PIN         255
#define FAN3_PIN         255

#define CASE_LIGHT_PIN 255
```
https://github.com/markniu/PandaPi/blob/master/Marlin2.x/pandapi/pins_PANDA_PI.h

markniu, 2022-06-07:
because the Pins of heating and Fans are connect and controlled by the stm32 not raspberry pi, and we need to let marlin which runs on Pi to ignore these pins by defined them as 255.

markniu, 2022-06-07:
we can use microUSB to send gcode to control Rpi-marlin and do not forget to plugin one jumper on the P2 which beside the microUSB
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

markniu, 2022-06-07:
do not know if we can set the gpio of raspberry pi as PWM, but I think the use the gpio on stm32  as PWM pin should be better .

GHubensG, 2022-06-08:
> do not know if we can set the gpio of raspberry pi as PWM, but I think use the gpio on stm32 as PWM pin should be better .

But then the amount of gcodes that is send to control my laser is limited by de STM32, that is why i wanted to use the RPI..

Thread 43 (2022-10-23):

PandaPi and Plotter

patofoto, 2022-10-23:
Unsure where to post my issue. Have my PandaPi running the latest version of Marlin with OctoPrint. I am using my PandaPi for a custom made plotter. I want Marlin as I want to use manual mesh bed leveling to create a mesh to try to keep the pressure of the pen or brush as even as possible against the paper. Everything is working as it should except when creating the mesh. I am using G29 commands to create my mesh. The first command is G29 S1 preceded by G29 S2 for each of the following mesh points. My problem is that the probing sequence starts at X0 Y0 Z0 which is at the position where the limit switches get triggered. X and Y positions are no problem since, from this first probing position, I need to move on the positive directions to probe the rest of the points. Z is an issue. I need to be able to move in the negative direction to take account for unevenness in the papar surface. Since the head is hitting the end stop, I cannot physically move.
How can I trigger an end stop but have zero Z have an offset?. Or how can I have the probing process start at a positive offset?.
Have tried tweaking Marlin firmare for hours and cannot get it to do what I want. In my head it should be something simple, and probably is, but I am burned out and cannot think clearly anymore. Any help or printing in the right direction would be soooo appreciated. If this is not the right place, please let me know.

Thread 44 (2022-10-30):

Klipper on Panda Pi 2.5?

padcom, 2022-10-30:
I've seen the nice (Klipper setup walkthrough)[https://github.com/markniu/PandaPi/wiki/How-to-install-klipper] and I was wondering what would I need to change to make it work with Panda Pi 2.5?

markniu, 2022-10-31:
Hello, only the version V2.8 and V2.9 support klipper. since the motor dirvers are connected to MCU and RaspberryPi at the same time in V2.8 and V2.9, but only connected to RaspberryPi in older version like V2.5.

Thread 45 (2023-01-10):

Z motor PINs for Klipper

patofoto, 2023-01-10:
Not able to make my Z motor working properly. Had been running Marlin with OctoPrint with our problems until I decided to change to Klipper. Have everything wired properly and have checked that all the cables are also working. Both X and Y are working properly also. Only Z is not working. This are my settings on my printer.cfg file:

```
[stepper_z]
step_pin: PB3  #check pin number. motor not moving
dir_pin: !PA15
enable_pin: !PC12 #check. suspect not the problem. energizing properly when issuing a STEPPER_BUZZ STEPPER=stepper_z
microsteps: 16
rotation_distance: 40
endstop_pin: ^!PA1 #check pin number. not triggering
position_endstop: 0.0
position_max: 5
```

Motor not moving at all or Z end stop triggers. I suspect PIN number is wrong for step_pin and endstop_pin.
I have looked over PIN designation on the Pins Map page. They match my current setup. What can be wrong?. Any help would be greatly appreciated.

markniu, 2023-01-10:
did the Z motor locked? if it can be locked or unlock that means the enable_pin works

patofoto, 2023-01-10:
Thank you for your time. Yes. The motor locks. enable_pin is correct. Can the numbers be wrong for the step_pin and the end stop_pin?.

markniu, 2023-01-10:
yes your pin numbers are right. which image of the OS are you using? or you can use other unused driver socket like E1 for the Z stepper.

patofoto, 2023-01-10:
Oh, I see a possible mistake I made. I am using a regular image of Mainsail OS. Also, even if I use another socket, the stop_pin for Z is also not working properly. It is not triggering at all.

markniu, 2023-01-10:
the reason should be the gpios on the raspberrypi influence the gpios from the stm32, for fixed that there is a python code after raspberrypi boot  in the pandapi image that will let all the gpios of raspberrpi as high input.

patofoto, 2023-01-10:
Understood. Thank you. Will try doing it correctly now.

patofoto, 2023-01-10:
Following the Klipper install steps here:

[https://github.com/markniu/PandaPi/wiki/How-to-install-klipper]

When running install-octopi.sh on my newly flashed image I get this error:

```
Ign:18 http://deb.debian.org/debian buster/main arm64 virtualenv all 15.1.0+ds-2
Err:18 http://deb.debian.org/debian buster/main arm64 virtualenv all 15.1.0+ds-2
  404  Not Found [IP: 146.75.30.132 80]
Fetched 194 MB in 20s (9,708 kB/s)
E: Failed to fetch http://deb.debian.org/debian/pool/main/p/python-virtualenv/virtualenv_15.1.0+ds-2_all.deb  404  Not Found [IP: 146.75.30.132 80]
E: Unable to fetch some archives, maybe run apt-get update or try with --fix-missing?
```

Important?

markniu, 2023-01-11:
I recommend you use the latest regular image OS if you want work with klipper.
to fix the z motor problem you can copy the file (/home/pi/gpio_pullup.py) from the pandapi image
and add the autorun command(python /home/pi/gpio_pullup.py) in the start shell /etc/rc.local
reference this link
[regular image](https://github.com/markniu/PandaPi/wiki/How-to-install-pandapi-to-the-latest-octopi-image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)

Thread 46 (2023-08-06):

Update Marlin

WispyCombover, 2023-08-06:
Selecting "update source" gives no option for updating Marlin to 2.1.x - it seems to be stuck on Marlin version 2.0.8

Thread 47 (2023-12-14):

Running Klipper mode fails

padcom, 2023-12-14:
PandaPi board v2.9, fresh install of PandaPi4_20210320.img, Running "Run Klipper mode" results in:

```
flash MCU firmware for klipper..
Failed to stop klipper.service: Unit klipper.service not loaded.
sb: no process found
open port
C
1
start flash .. / / /klipper/out/klipper.bin
 sb: cannot open /home/pi/klipper/out/klipper.bin : No such file or directory

Can't open any requested files.

Transfer incomplete
stdclose:128

 closed!
```

What should I do to run Klipper?

padcom, 2023-12-14:
Nevermind :) RTFM.

Closed 2023-12-14.

Thread 48 (2023-12-14):

Is the RT kernel absolutely necessary when running Klipper on PandaPi 2.9?

padcom, 2023-12-14:
I am wondering if it is absolutely necessary to run the real-time Linux kernel when the communication with stepper motors is done via the on-board microcontroller (STM32)? If not, is it possible to use a newer base image instead of the ancient one provided by PandaPi?

Flashing could be a problem, but maybe there is a repo I could clone to have the phtml to be able to flash klipper?

For that matter, what is needed to start the flashing process? I can see the `sb` utility is being used to send the firmware over ttyAMA0. Is the `ymode0` enough to get the process started (besides stopping the `klipper` service of course?)

Thread 49 (2024-05-11):

Is this project abandoned?

adaliszk, 2024-05-11:
It looks like many of the embedded images are in disarray, the drivers are outdated, the maintainer does not seem to be all that active in the issues, and the repo hasn't been updated for two years now.

Are there plans to maintain this project? Especially when we do support it with money?

markniu, 2024-05-15:
Thank you so much for the support at early age, and that support this project from 2019 to 2022, and actually there is a only one person for all the things including develop,factory make,sale ,shipping , support.  and the total number of sell is only about 310 pcs from 2019.9 to 2022.3, this project have been stopped maintain although I didn't want to, and set the board out of stock on the store page in the past 2 year.  I am very sorry and sad for that, but hope you can understand.

adaliszk, 2024-05-15:
Please add a statement in the README that it is no longer maintained and archive the repo. It is all good, the issue was really with the missing information 😉
