markniu/PandaPi/doc/Schematic_PandaPi_V29_2022-02.pdf

## POWER ENDSTOP

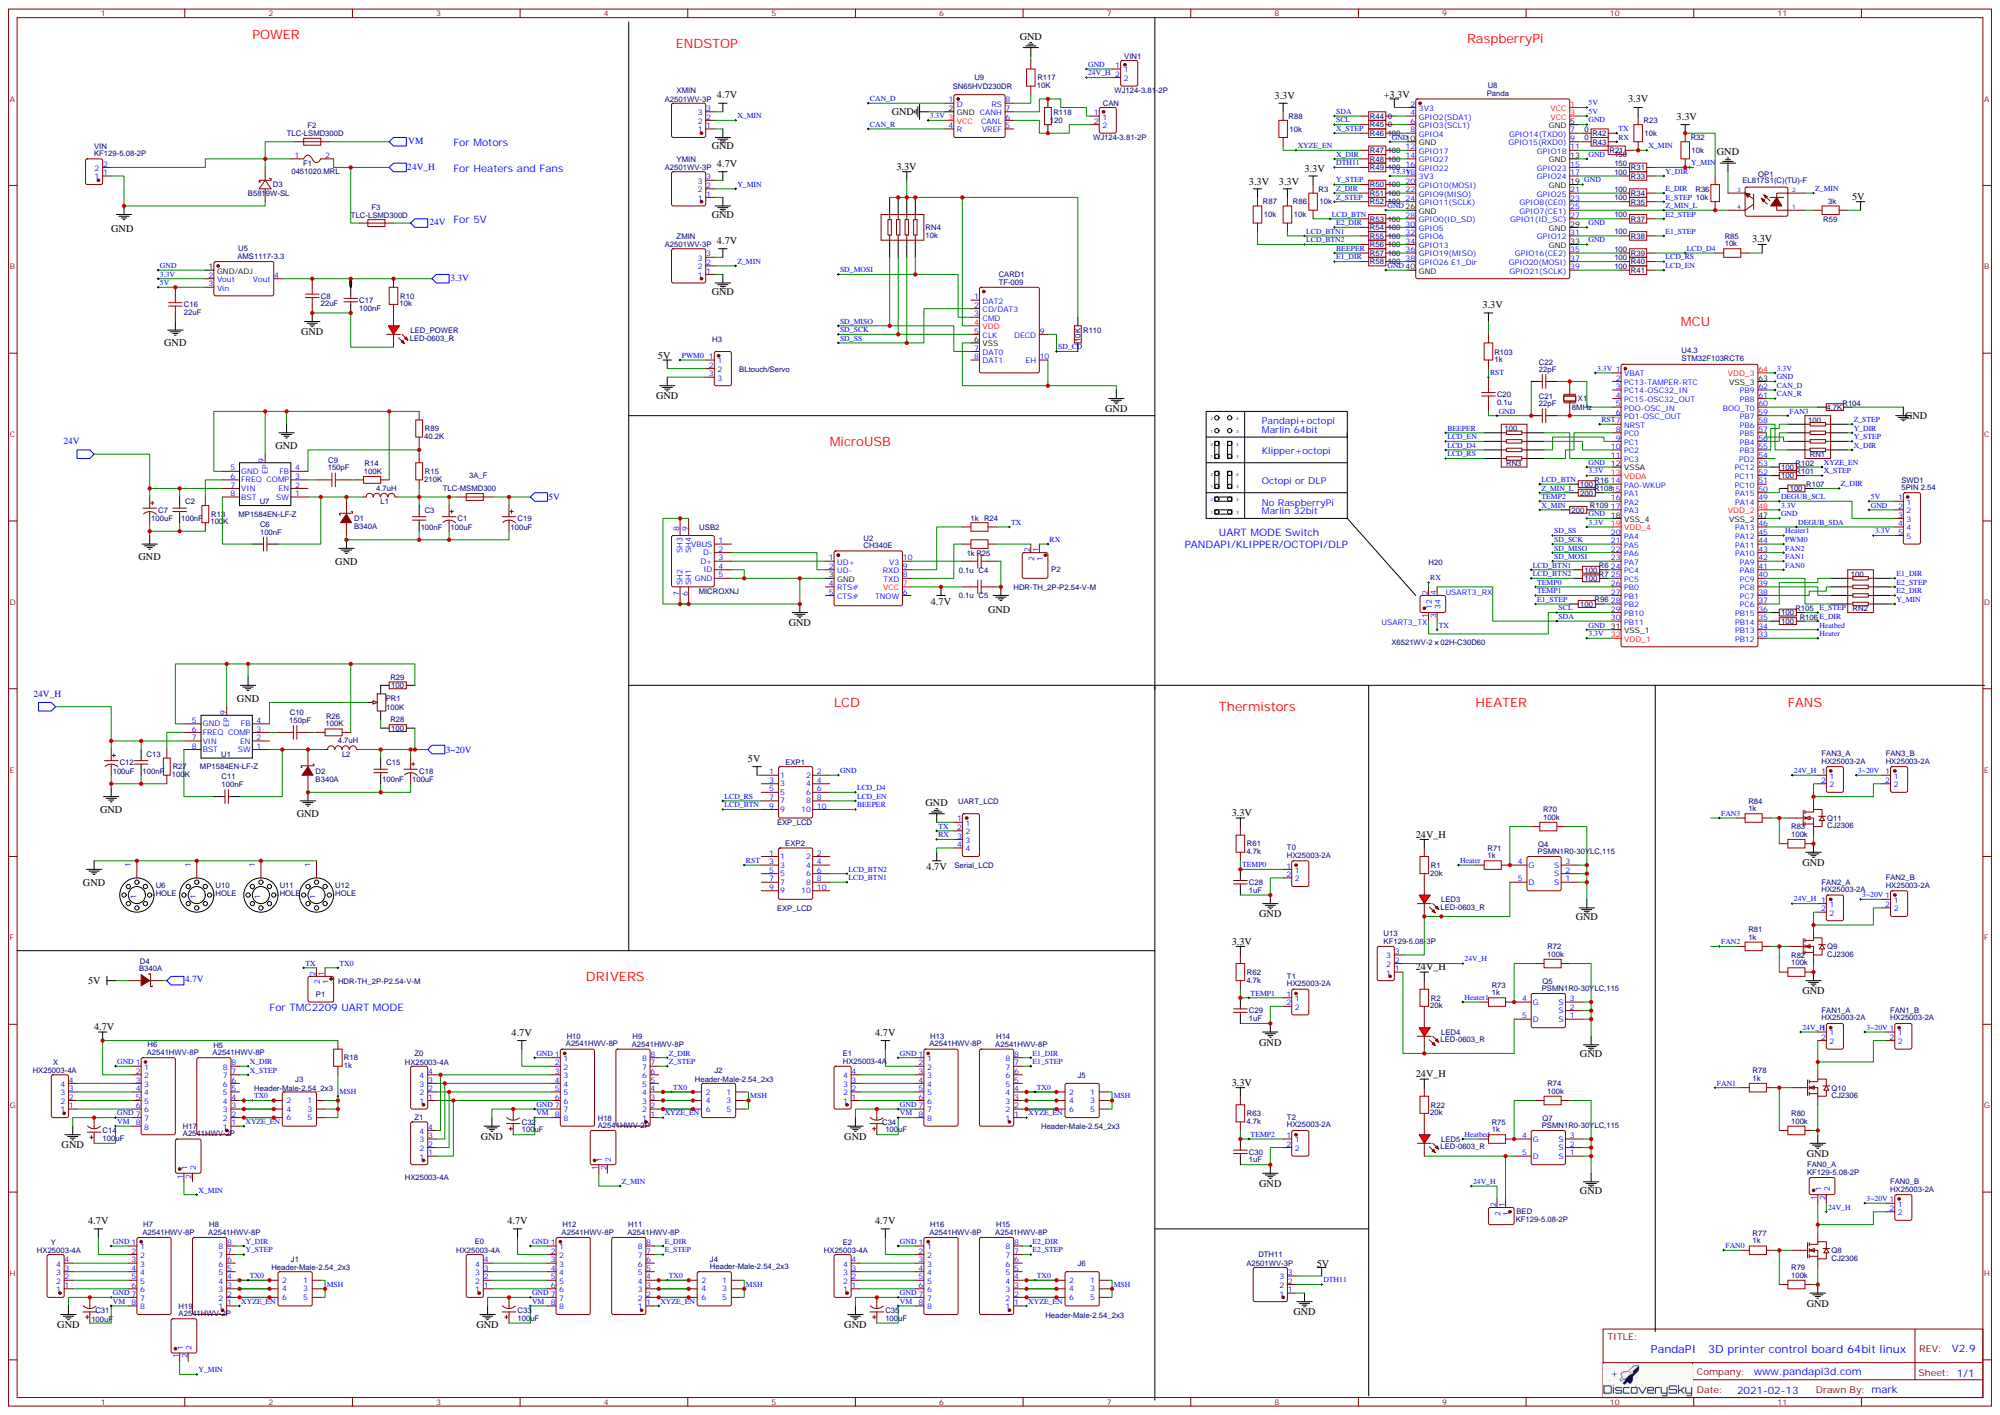
[picture p4: page 1]

For Heaters and Fans

UART MODE Switch
PANDAPI/KLIPPER/OCTOPI/DLP
