markniu/PandaPi/doc/Schematic_PandaPiV2.8.pdf

## POWER ENDSTOP

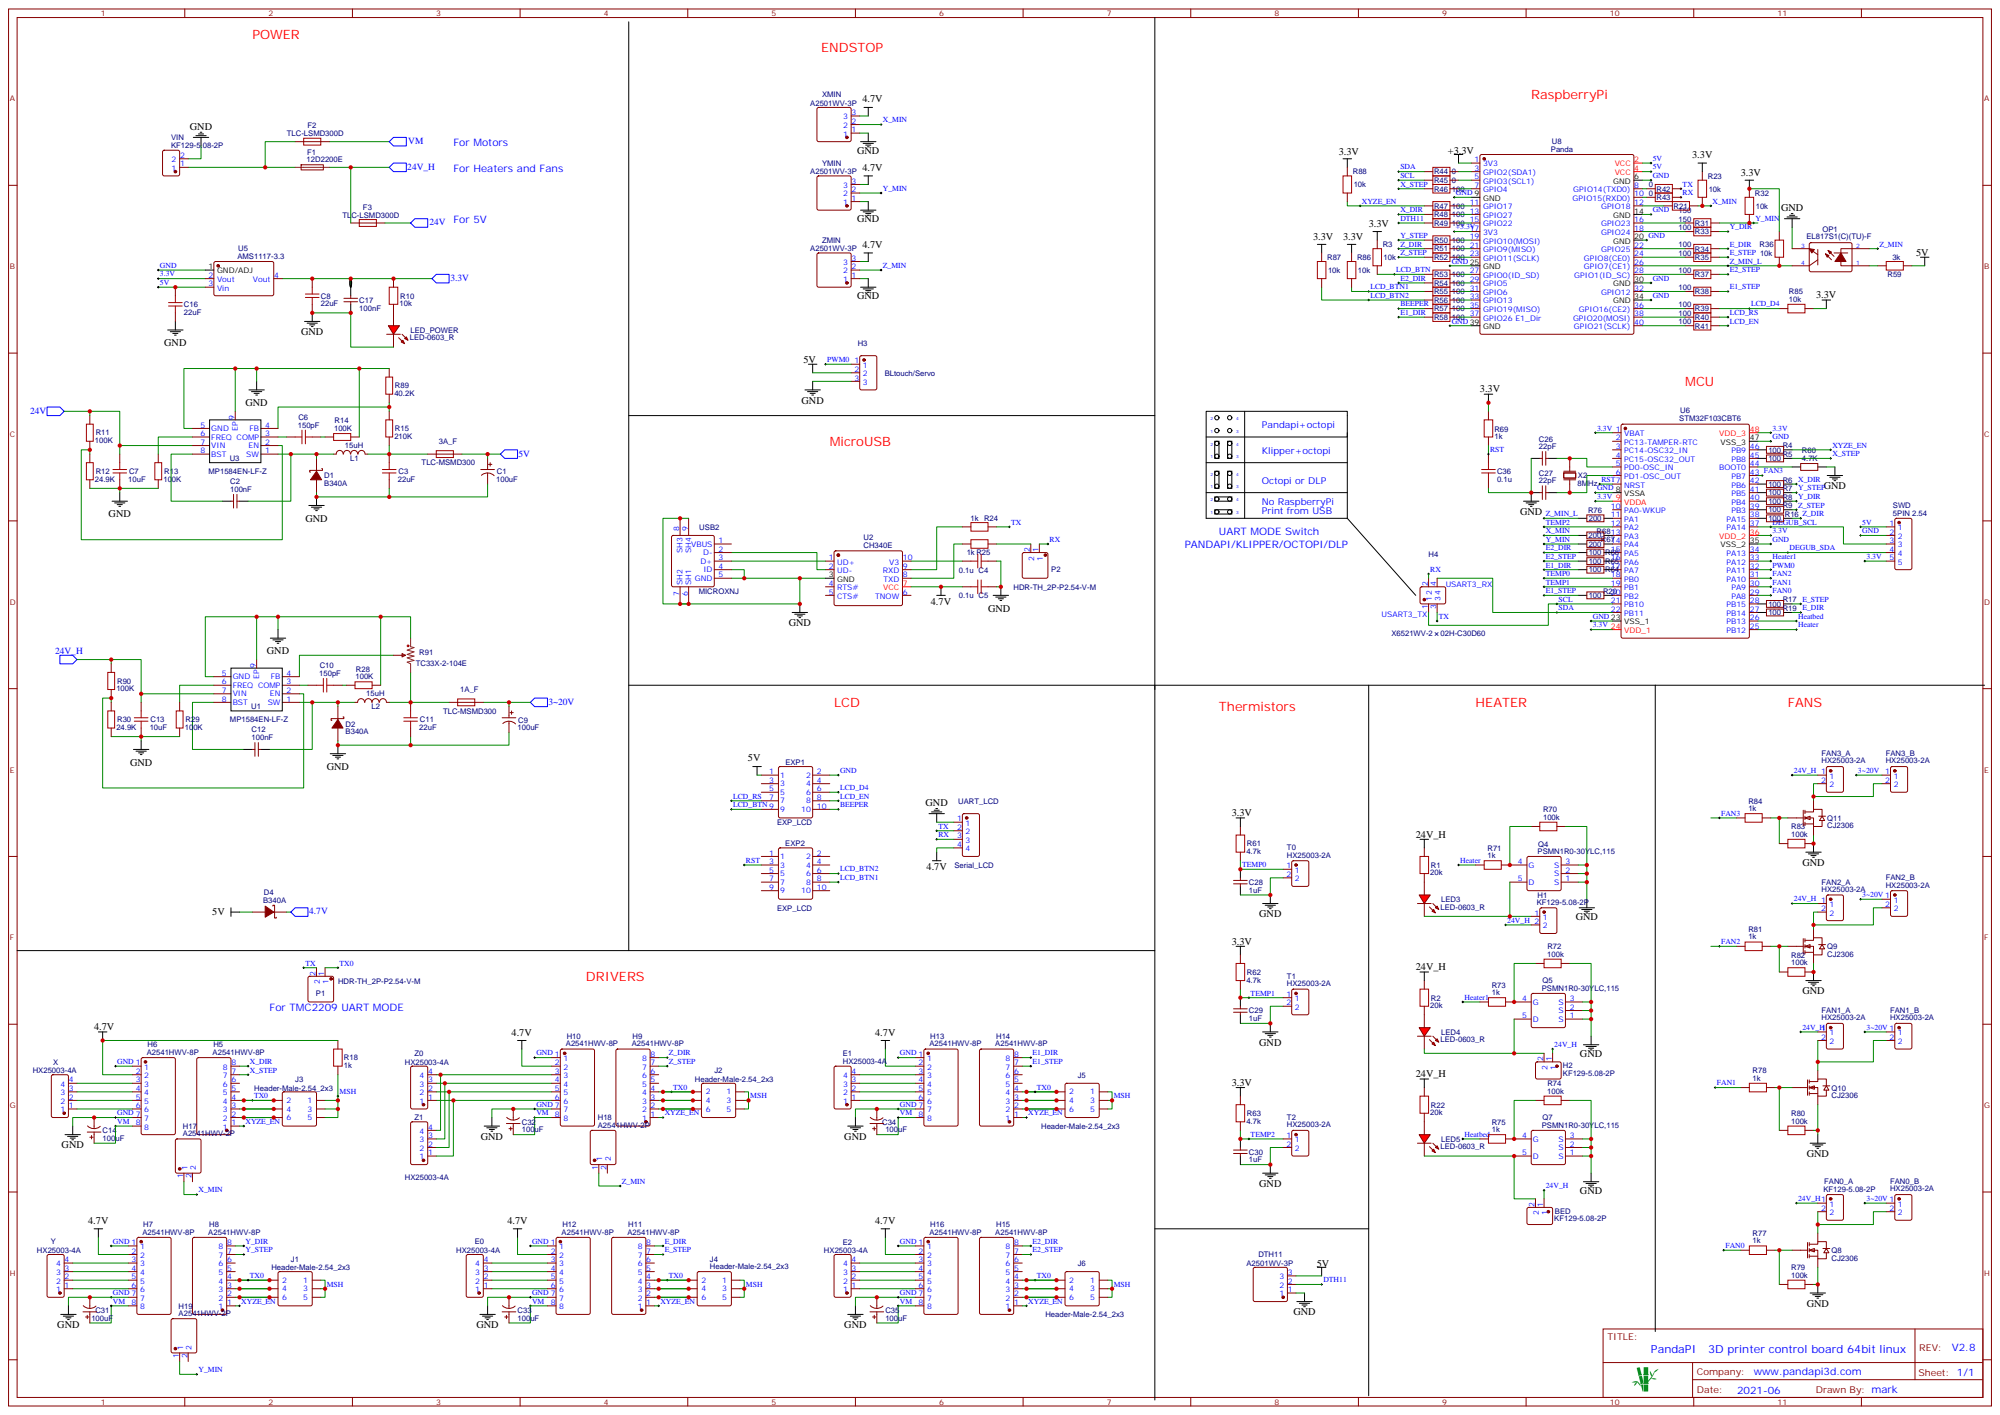
[picture p5: page 1]

For Heaters and Fans

UART MODE Switch
PANDAPI/KLIPPER/OCTOPI/DLP
