markniu/PandaPi/doc/PandaPiv25_sch.pdf

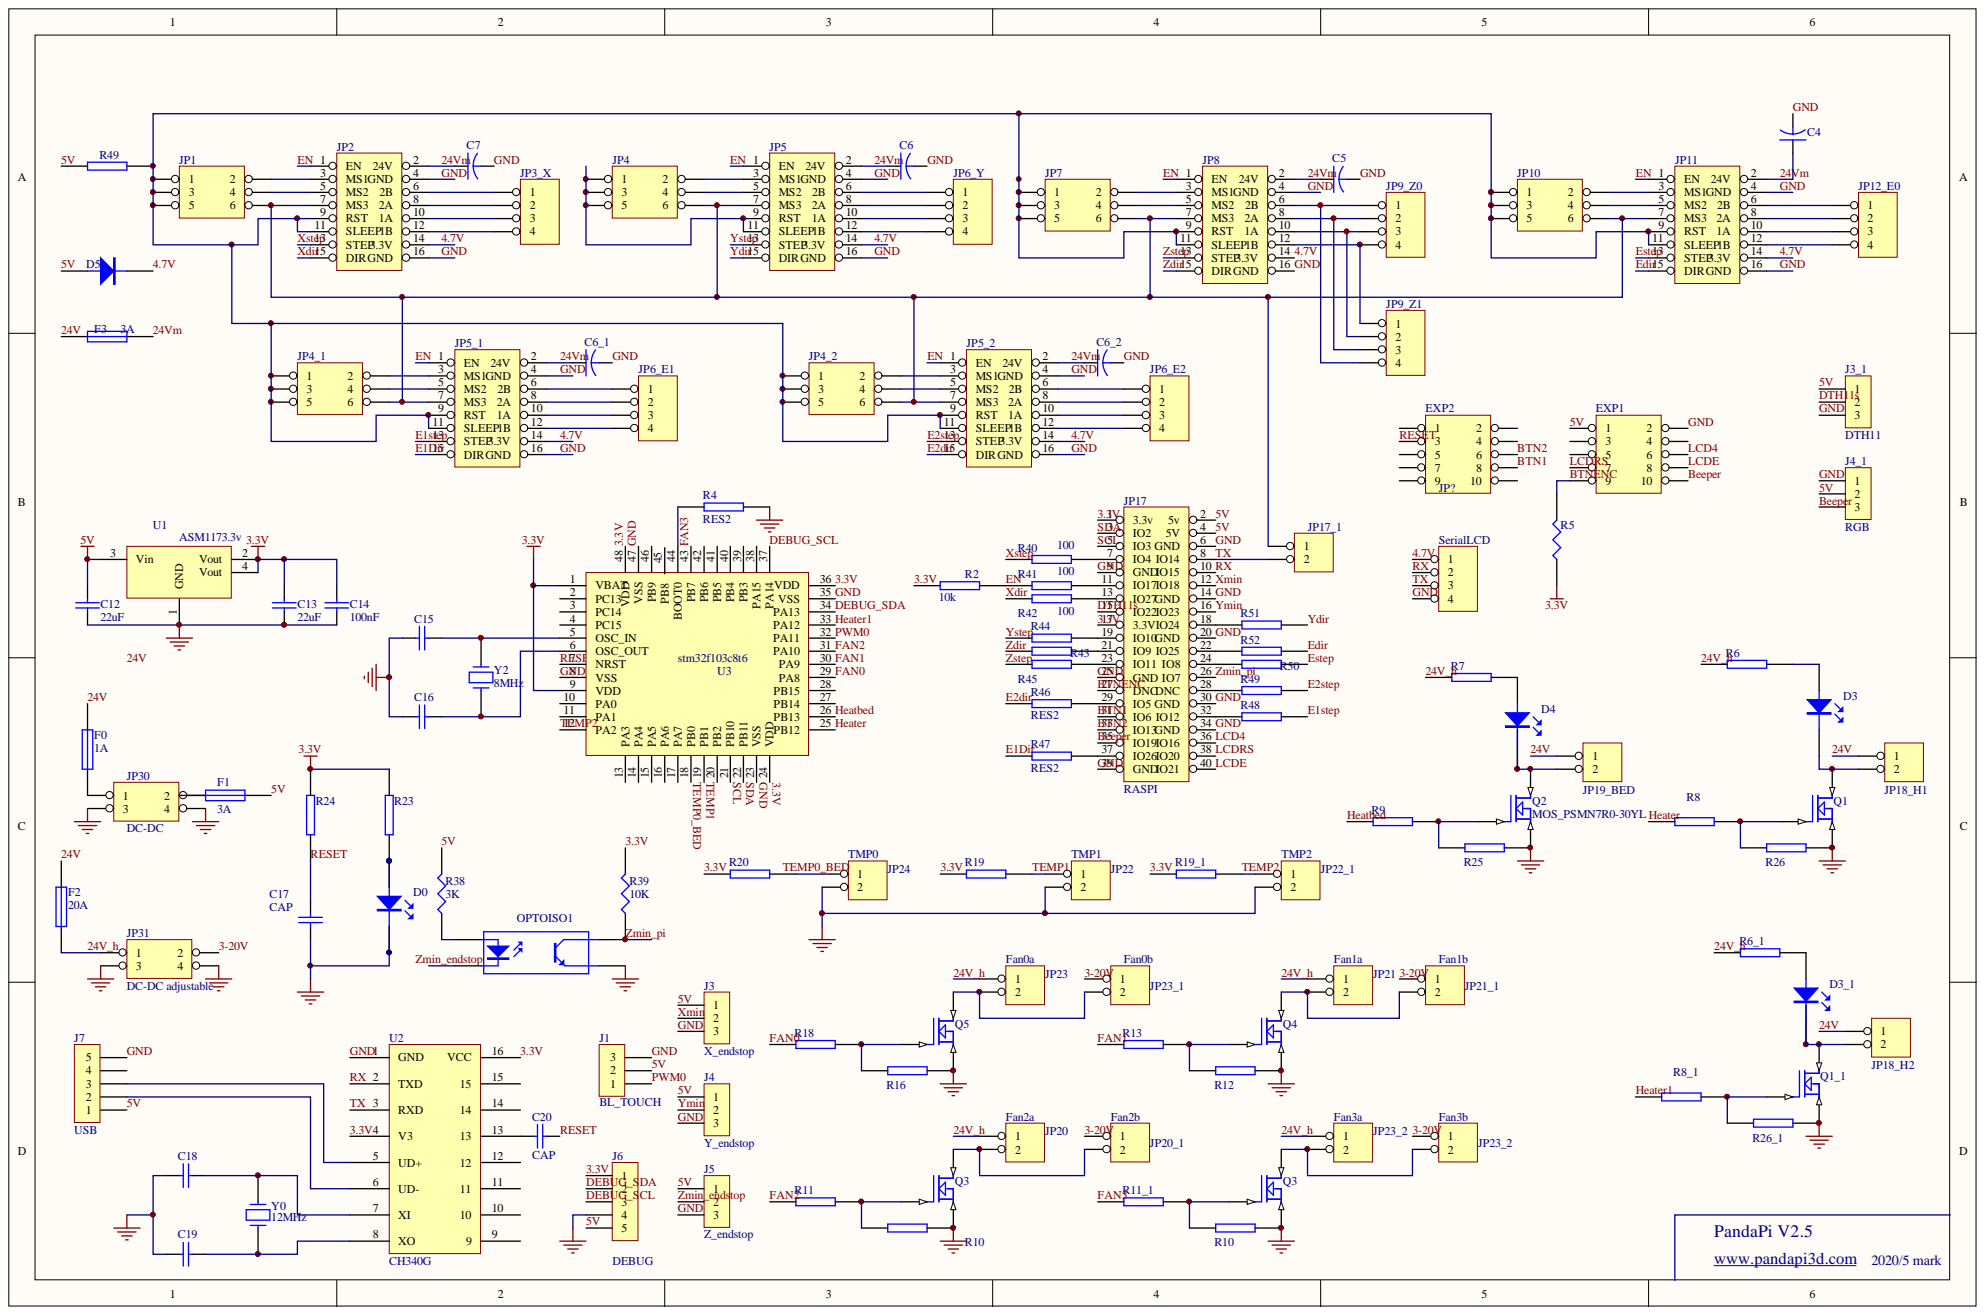
[picture p6: page 1]
