markniu/PandaPi/doc/PandaPiV2_sch.PDF

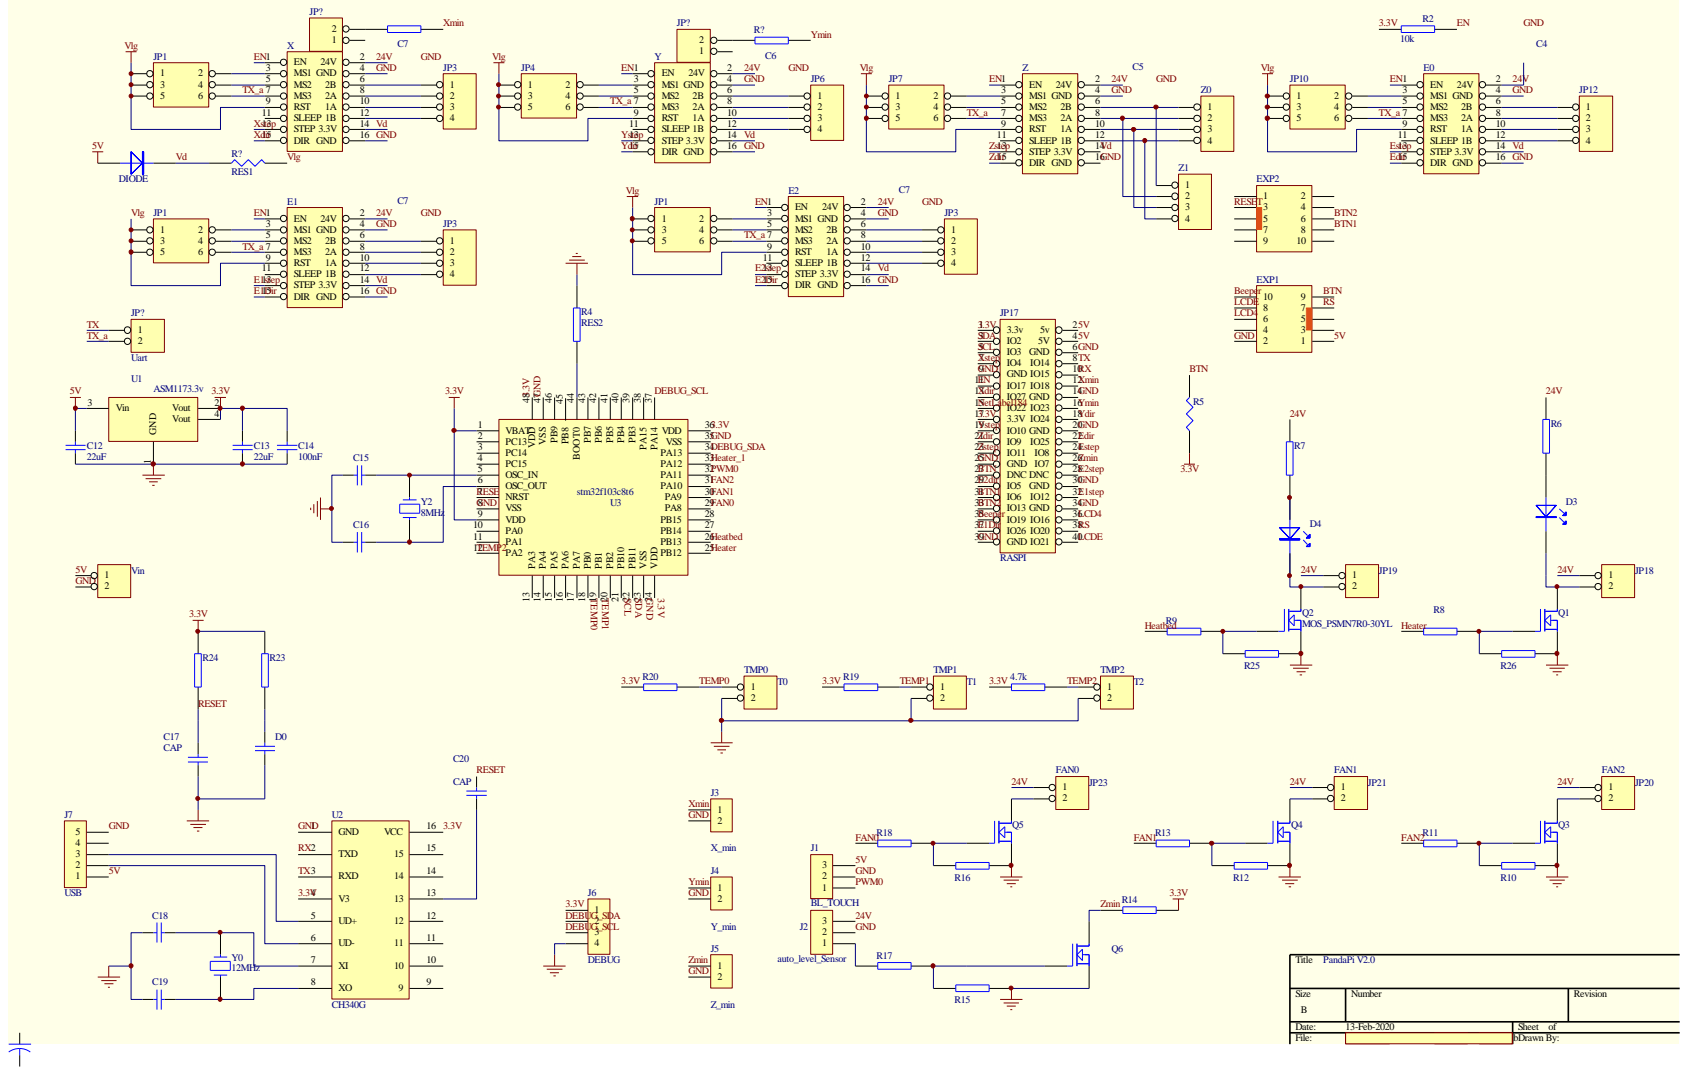
[picture p7: page 1]
