markniu/PandaPi/bootloader/V29_SD/CODE/APP/flash.h

#ifndef __FLASH_H
#define __FLASH_H

#include "stm32f10x.h"

#include <string.h>

#include "typedefs.h"
#include "util.h"

#define FLASH_PROG_TEST_EN          ( 1 )

#define FLASH_PAGE_SIZE             ( 0x800 )
#define FLASH_START_ADDR            ( 0x08070000 )
#define FLASH_EMPTY                 ( 0xFFFFFFFF )

#define FLASH_STAT_CHK(stat)        if( FLASH_COMPLETE != (stat) )      \
                                        return FuncErr
FStat Flash_Init(void);
FStat Flash_ProgTest(void);
FStat Flash_Write(uint32_t Addr, void *WriteBuf, uint32_t Len);
FStat Flash_Erase(uint32_t Addr, uint32_t Len);

#endif  //#ifndef __FLASH_H
