markniu/PandaPi/bootloader/V29_SD/CODE/SYSTEM/usart.h

#ifndef __USART_H
#define __USART_H
#include "stdio.h"	
#include "sys.h" 

#define USART_REC_LEN  			200
#define EN_USART3_RX 			1
	  	
extern u8  USART_RX_BUF[USART_REC_LEN];
extern u16 USART_RX_STA;

void UART_init(u32 bound);
#endif
