markniu/PandaPi/(commit log)

2019-08-23 add source code
    [Configuration.h, Configuration_adv.h]
2019-09-12 support octoprint and fix bugs
    [Configuration.h]
2019-09-25 change folder name
    [Configuration.h, Configuration_adv.h]
2019-09-29 compile freeze bug
    [Configuration.h]
2019-09-30 marlin code
    [Configuration.h]
2019-10-01 and BLtouch code;fix temperature not stable bug
2019-10-02 add support BLtouch PWM
2019-10-12 parameter for ender3 print bltouch bed offset
    [Configuration.h]
2019-10-16 add store setting and pid setting
    [Configuration.h]
2019-10-18 homing speed is too slow
    [Configuration.h]
2019-10-20 support BLtouch PID
2019-10-28 send the raw PID data to shield without scale
2019-11-04 board fan opened by the motor enable signal;mesh board leveling;auto read pi3/p4 version;clear some log;
2019-11-04 update new firmware;support runout sensor
    [Configuration.h]
2019-11-11 fix BLtouch compile error
    [Configuration.h]
2019-11-27 support TMC2209 sensoless home xy
    [Configuration_adv.h]
2019-11-30 TMC2209 init
    [Configuration_adv.h]
2019-12-08 fix the printing with TMC driver bug in stepper_indirection.h
    [Configuration.h]
2019-12-24 auto find U disk path installed of the static path /media/usb before
    [Configuration.h]
2019-12-28 add marlin2.0 test version,have done a few test of the sd printing, octoprint.
    [Configuration.h, Configuration_adv.h]
2019-12-31 fix that gpio speed too high for driver
    [Configuration.h]
2020-01-01 fix the serial print stuck
2020-01-23 MCU firmware of stm32f103c8t6
2020-01-31 support V2 hardware;add octoprint serial baud rate BAUDRATE_TNT
    [Configuration.h]
2020-02-04 add tnt baudrate for octoprint
    [Configuration.h]
2020-02-05 add PID auto tune
    [Configuration.h]
2020-02-06 PID auto tune optimization
2020-02-09 fix bltouch compile bug
    [Configuration.h]
2020-02-13 support e2prom store
    [Configuration.h]
2020-02-13 add hardware schematic
2020-02-19 PID seting not successful
2020-02-20 add runout sensor
    [Configuration.h, Configuration_adv.h]
2020-02-27 optimize precision of temperature from 1 degree to 0.1
2020-02-28 sync source code that fixed some bugs from 1.9 branch
    [Configuration.h, Configuration_adv.h]
2020-02-28 optimize the precision of temperature to 0.1
2020-03-01 fix the read temperature error
2020-03-01 fix the read PID temperature error
2020-03-05 support TMCsteper TMC2208 TMC2209 and sensorless homing whic can work,but need to do more test .
    [Configuration.h, Configuration_adv.h]
2020-03-06 support TMCsteper TMC2208 TMC2209 and sensorless homing which can work
    [Configuration_adv.h]
2020-03-06 update the default pid value
    [Configuration.h]
2020-03-07 add checksum in the data between MCU and raspberry pi
2020-03-12 update to marlin 2.0.4.4
    [Configuration.h, Configuration_adv.h]
2020-03-13 open board fan
    [Configuration.h]
2020-03-14 fix the auto bed level compile error
    [Configuration.h]
2020-03-14 fix the temperature read unstable
2020-03-14 nozzle temperature error
2020-03-16 have test BLTOUCH and inductive sensor(FIX_MOUNTED_PROBE) are ok
2020-03-18 update EEPROM store code;fix LCD display delay bug
    [Configuration.h]
2020-03-20 fix stop printing failed,display noise
2020-03-21 pandapi pins update
    [Configuration.h, Configuration_adv.h]
2020-03-21 rename it as Marlin2.x
    [Configuration.h, Configuration_adv.h]
2020-03-21 rename Marlin1.x
    [Configuration.h, Configuration_adv.h]
2020-03-22 fix LCD display noise;set the TMC2209 motor current to 500ma
    [Configuration.h, Configuration_adv.h]
2020-03-23 fix the compile error with TMC_DUBUG
    [Configuration.h]
2020-03-24 settings for ender3, non sensorless by default
    [Configuration.h, Configuration_adv.h]
2020-04-04 calibrate the motor speed from faster to normal; fix U drive mount path for next img.
    [Configuration.h, Configuration_adv.h]
2020-04-05 open temperature runaway in marlin
    [Configuration.h]
2020-04-05 change the default pid value
    [Configuration.h]
2020-04-08 fix 2 extruders compile error; put pins_PANDA_PI.h to the top folder so that can edit it from the web browser
2020-04-13 set default value of BLtouch probe offset https://www.thingiverse.com/thing:3584158
    [Configuration.h]
2020-04-13 open EEPROM_AUTO_INIT // Init EEPROM automatically on any errors.
    [Configuration.h]
2020-05-23 fix the compile error when enable the FILAMENT_RUNOUT_SENSOR .
    [Configuration.h, Configuration_adv.h]
2020-06-10 fix the POWER_LOSS_RECOVERY(Creality3D) and M48 compile error.
    [Configuration.h, Configuration_adv.h]
2020-06-12 PandapiV2.5 schematic
2020-07-07 Process the data of UART(uart0,octopi) separately:uart0(SERIAL_PORT) octopi(SERIAL_PORT_2)
    [Configuration.h]
2020-07-11 fix hotend2 can not heat
2020-07-29 fix compile error when enable FILAMENT_RUNOUT_DISTANCE_MM.
2020-07-31 add marlin2.0.6 test
    [Configuration.h, Configuration_adv.h]
2020-07-31 can remap the 3 heat and 3 temp thermistor
2020-08-09 add pandapi 8008480 touch screen
    [Configuration.h, Configuration_adv.h]
2020-08-11 disable DGUS_LCD_UI_PANDAPI in default configure
    [Configuration.h]
2020-08-17 octoprint connect problem
    [Configuration.h]
2020-08-17 update marlin to 2.0.6
    [Configuration.h, Configuration_adv.h]
2020-08-19 need to disable DISABLE_INACTIVE_EXTRUDER for all the x motors use the same enable pin
    [Configuration.h]
2020-09-26 add support temperature sensor pt100 and spi max31856 module;put some configure to configurel.h for the easy mode page
    [Configuration.h, Configuration_adv.h]
2020-09-30 put some configure to configurel.h for the easy mode page
    [Configuration_adv.h]
2020-10-26 add support PT100 sensor MAX31856_PANDAPI
    [Configuration.h]
2020-11-04 add new configure file for ender5
    [Configuration.h]
2020-11-25 Open the firmware of stm32f103 source code
2021-01-11 compatible for arm64 pi4, fix usb drive mount bug.
2021-02-22 add pandapiV2.8 schematic
2021-03-06 support serial LCD display sync with Octoprint,you can control the octo printing from the lcd, or control the lcd printing from octopi.
2021-03-17 for install klipper together,add bootloader,flash firmware from webpage
2021-03-19 disable some print log
2021-03-19 compatible with klipper
2021-03-29 add SET_FAN2_ON in configuration.h,enable it will set Fan2 on at startup
    [Configuration.h]
2021-03-31 set Fan2 always on at speed 70% while idle, 100% while the motor is work.
    [Configuration.h]
2021-04-08 fix the runout sensor can not be detected bug
2021-05-21 M48 replace the function random with linux_random
    [Configuration.h, Configuration_adv.h]
2021-05-25 update to the latest marlin version marlin2.0.8
    [Configuration.h, Configuration_adv.h]
2021-05-26 set the configure to ender3 as default
    [Configuration.h]
2021-05-30 add the CASE_FAN_SPEED_IDLE to the configuration.h for change the case fan speed while in idle
    [Configuration.h]
2021-06-08 fix the serial screen can not received data from marlin2.0.8
    [Configuration.h]
2021-06-25 support DGUS_LCD_UI_MKS firmware, just enable it in the Configuration.h
    [Configuration.h, Configuration_adv.h]
2021-06-25 add delta configuration, compiled ok, but not test
    [Configuration.h]
2021-07-07 fix the display problem that can not tune while printing octopi files
2021-08-28 fix the multi Z steppers lose step because of speed to the driver's input step pin is too high, need add delay.
    fix the multi Z steppers lose step because of speed to the driver's input step pin is too high, need add delay.
2022-02-23 upload new Marlin for stand alone mode print
    upload new Marlin for stand alone mode print
    [Configuration.h, Configuration_adv.h, esp32.csv]
2022-02-24 support bootloader uploading firmware from sd card
    support bootloader uploading firmware from sd card
    [Configuration.h]
2022-03-12 add schematic for pandapi V2.9
    add schematic for pandapi V2.9
2022-03-18 support PANDA_CAN_MODULE for stm32 platform
    support PANDA_CAN_MODULE for stm32 platform
    [Configuration.h]
2022-03-19 upload flash tool for firmware upload to stm32
2022-04-07 fix compile error for delta printer
    fix compile error for delta printer
2022-05-30 add code support Bed Distance Sensor
    [Configuration.h, Configuration_adv.h]
2022-05-31 communicate to bd sensor ok
2022-06-05 fix calibrate 23 24 point are the same
    [Configuration.h, Configuration_adv.h]
2022-06-07 optimize the code struct
    [Configuration.h]
2022-06-08 disable the usb serial and then we use the PA11
    Serial.end(); // disable the usb serial and then we use the PA11
    [Configuration.h]
2022-06-11 Support BDsensor code
    [Configuration.h, Configuration_adv.h]
2022-06-12 add i2c software library
2022-06-12 add bd sensor files
2022-06-15 display the BD sensor Z hight on the LCD12864
2022-06-17 run marlin on pi is OK
2022-06-18 Fix the BDsensor can not adjust z axis
2022-07-07 fix the temperature data error
2022-07-13 support BDsensor mesh bed level
    [Configuration.h]
2022-07-13 support BDsensor mash bed level
    [Configuration.h]
2022-07-16 support mesh bed level with BDsensor
    [Configuration.h, Configuration_adv.h]
2022-07-16 recovery the configure
    [Configuration.h]
2022-09-28 update to marlin2.1.1 just compile ok, have not test all function
    update to marlin2.1.1 just compile ok, have not test all function
    [Configuration.h, Configuration_adv.h, esp32.csv]
2022-10-03 fix heat bed dgus display bug
2026-01-30 Opensource the PCB files
