markniu/PandaPi/(notices)

Notices in the files:
Marlin2.x/pandapi/Configuration_adv.h:
define TOUCH_UI_UTF8_COPYRIGHT // © ®
